rv456/BowlsEye/Code/Pi_BowlsEyeMain/README.md

# Pi_BowlsEyeMain

Main program for raspberry pi

    make
    ./main
