rv456/BowlsEye/Code/SPI/README.md

Simple SPI test using [wiringPi](http://wiringpi.com/) library for reading values from external ADC.

Usage:

    make
    ./spi
