rv456/BowlsEye/Code/StepperMotor/README.md

Example of controlling the stepper motor.  Build and run with:
    
    make
    ./stepper
