rv456/BowlsEye/Code/Thread/README.md

Threading demo using pthreads

Usage:

    make
    ./main
