rv456/BowlsEye/Resources/Presentations/13febpresentation.odp

## Team 18: BowlsEye

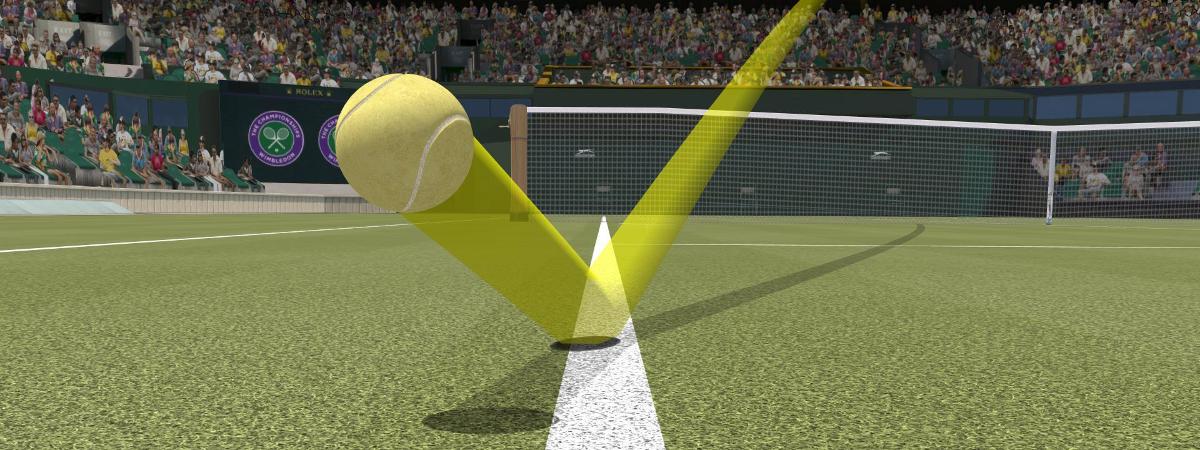
[picture p3: figure]
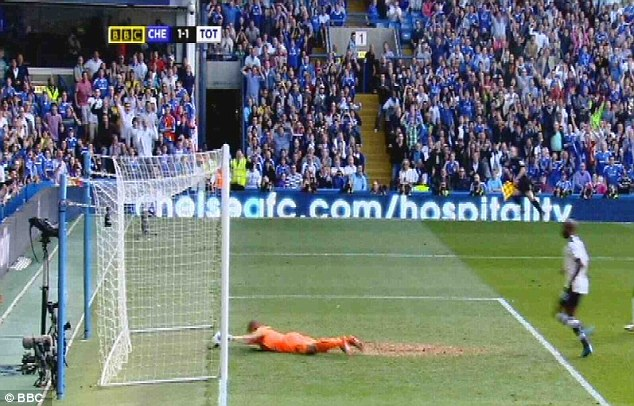
[picture p4: figure]
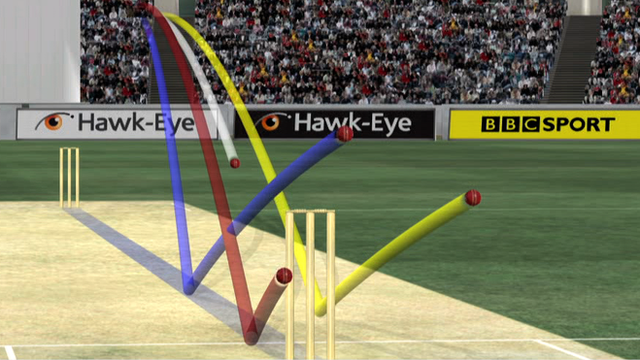
[picture p5: figure]
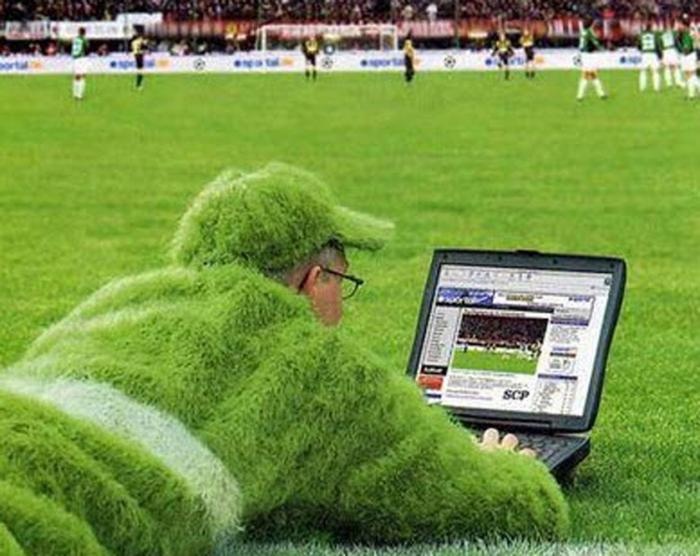
[picture p6: figure]

## Lawn Bowls

- Olympic sport first played in the 13th century
- Player with ball rolled closest to jack wins
- Traditionally measured with tape measure: unreliable!
- Use Raspberry Pi to implement electronic distance sensor

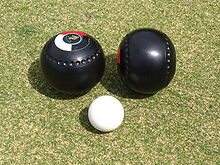
[picture p7: figure]
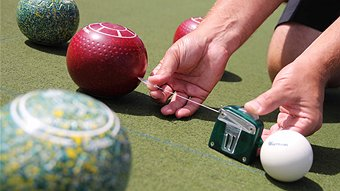
[picture p8: figure]

## System Diagram

## Questions?

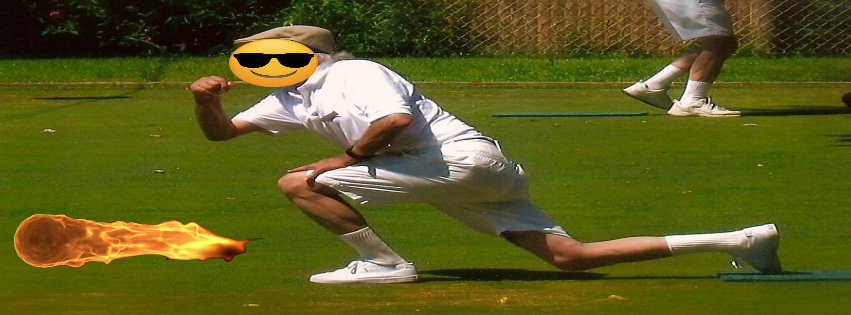
[picture p9: figure]
