rv456/BowlsEye/CAD/base.png

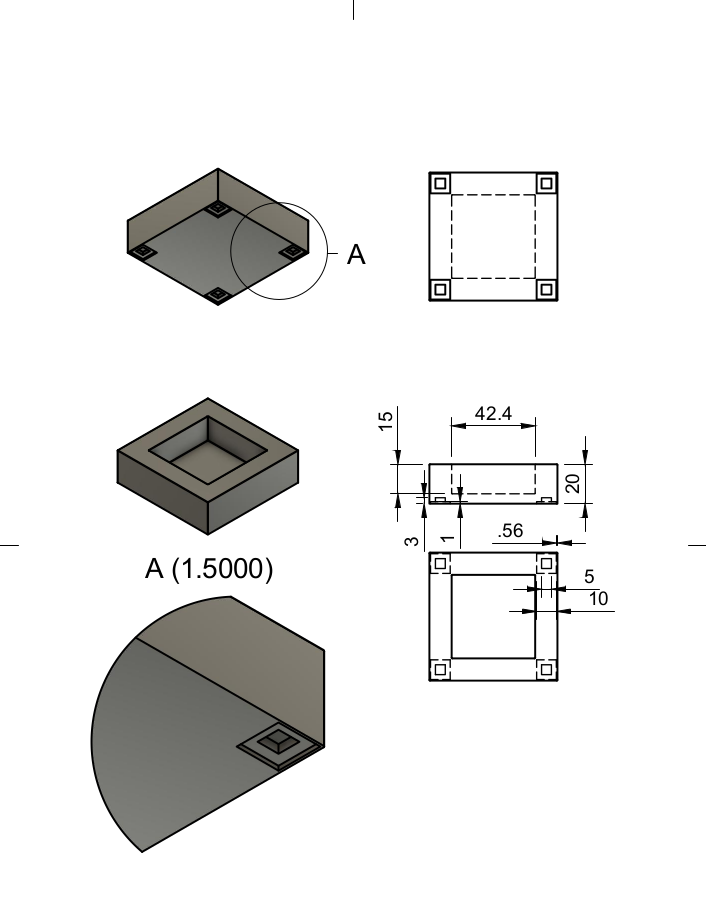
CAD/base.png
