rv456/BowlsEye/CAD/leg.png

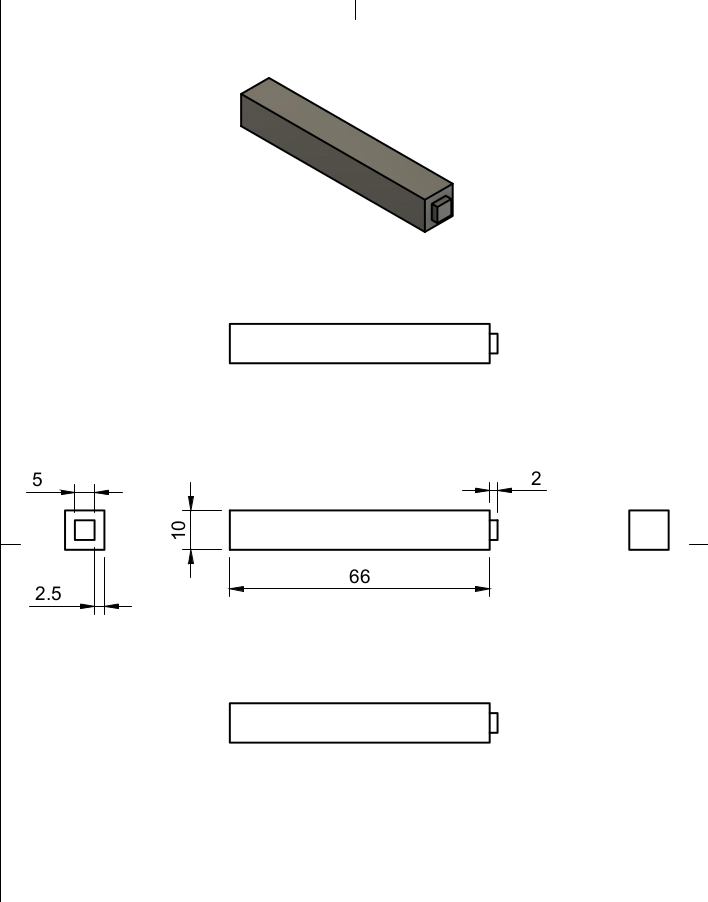
CAD/leg.png
