rv456/BowlsEye/Resources/Misc/gui_screenshot.png

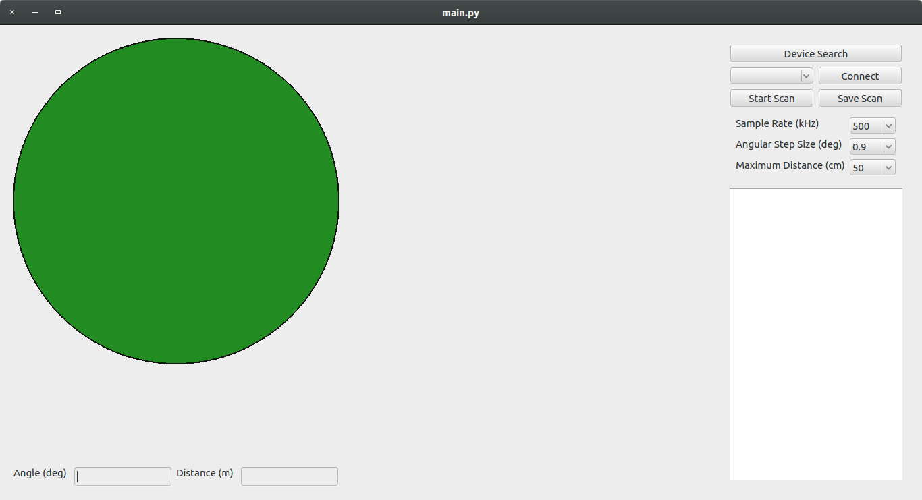
Resources/Misc/gui_screenshot.png
