rv456/BowlsEye/Resources/Misc/Proto1Brd.png

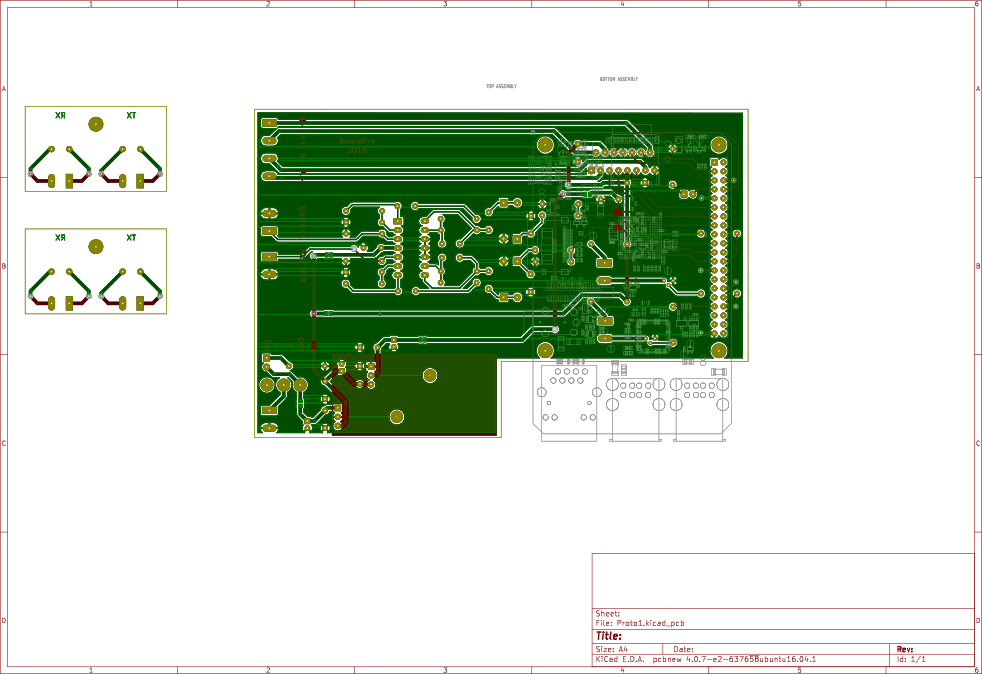
Resources/Misc/Proto1Brd.png
