rv456/BowlsEye/Resources/Misc/Proto2Brd.png

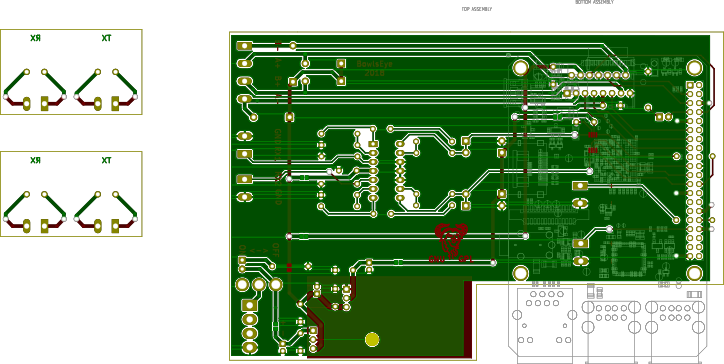
Resources/Misc/Proto2Brd.png
