rv456/BowlsEye/Resources/Misc/softwareDiagram.png

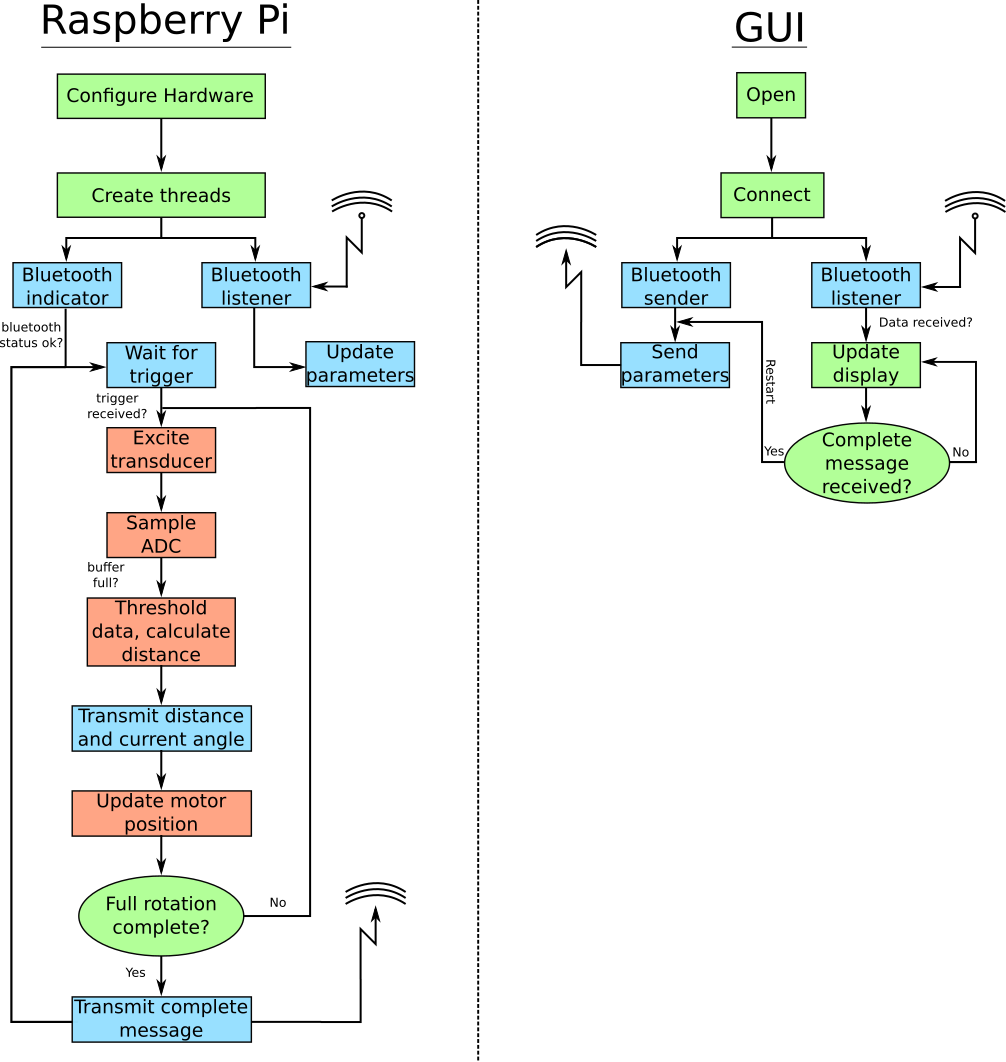
Resources/Misc/softwareDiagram.png
