rv456/BowlsEye/Resources/RPi/Raspberry-Pi-B-Plus-V1.2-Mechanical.dxf

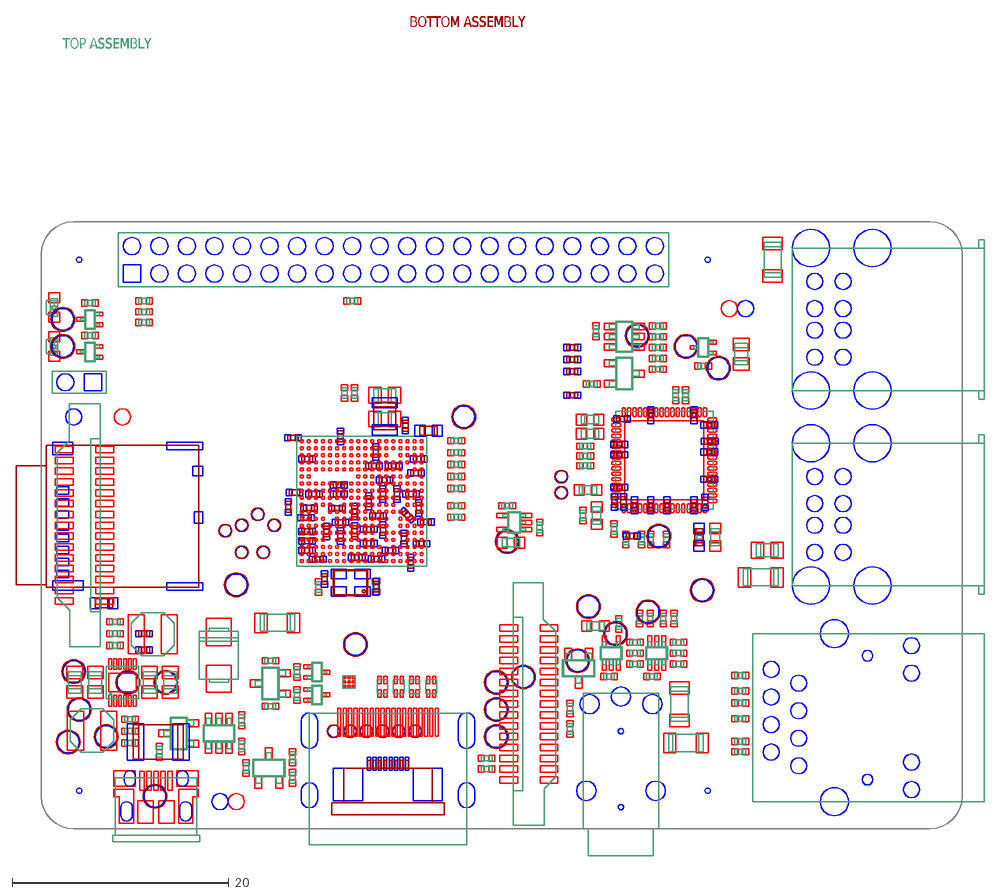
[picture p16: CAD file, 2018-03-19]
Resources/RPi/Raspberry-Pi-B-Plus-V1.2-Mechanical.dxf
BOTTOM ASSEMBLY
TOP ASSEMBLY
