rv456/BowlsEye/(list of files, cad)

Other CAD files:
CAD/box_model_v1.f3d
