rv456/BowlsEye/CAD/assembly.png

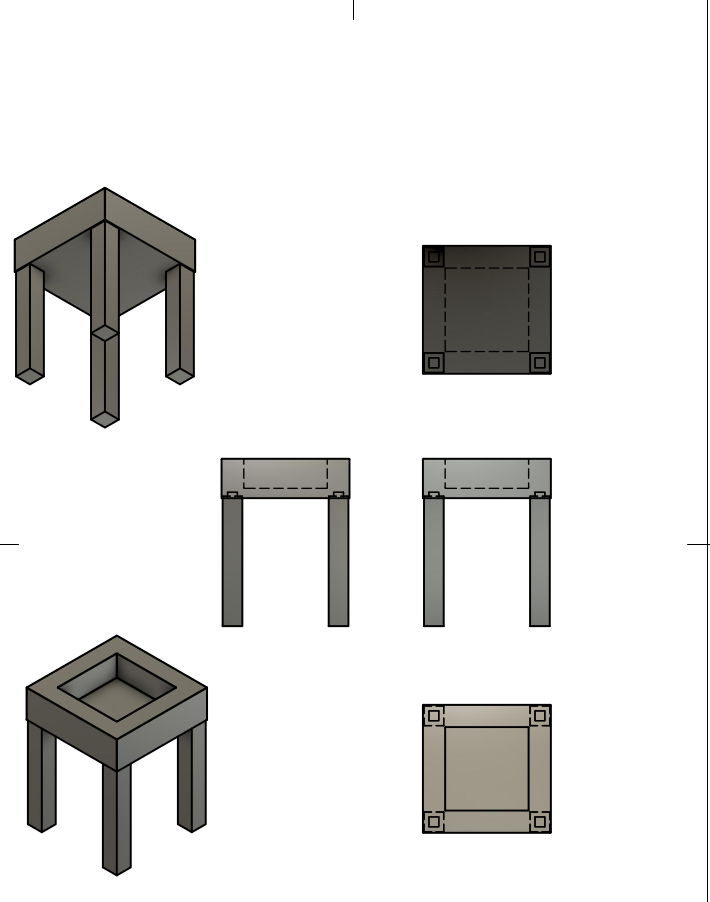
CAD/assembly.png
