rv456/BowlsEye/Results/F0001TEK.JPG

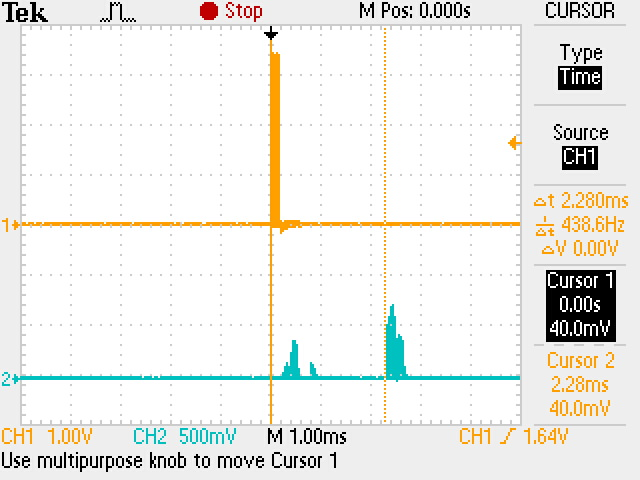
Results/F0001TEK.JPG
