rv456/BowlsEye/Results/F0002TEK.JPG

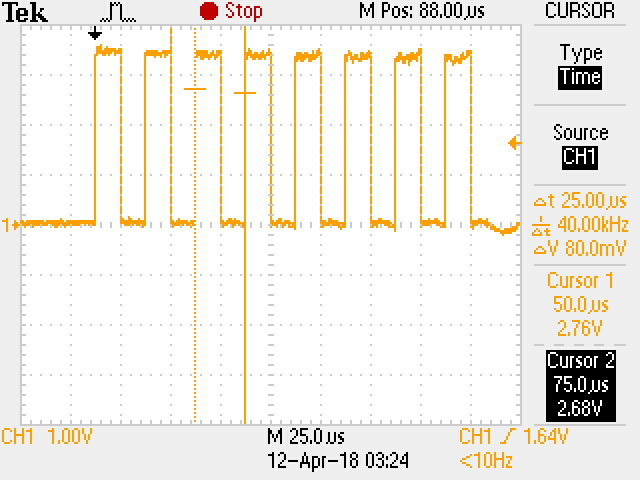
Results/F0002TEK.JPG
