rv456/BowlsEye/Planner/todo.odt

To Do List

Urgent: FOR NEXT WEEK (14/2/18):

ADC interface:(H+C)

Spi w/ any signal

Stepper motor stepping research:(H)

drive signal

hardware required

Ultrasound w/ scope & sig gen:(C)

signal level in/out

distance(?)

rectify(?)

Breadboarding:

ultrasound(C)

motor driving(H)

Presentation:(H+C)

Slides: system block diagram

Readme: description → plan

answer list of questions

Gantt chart(?)

pictures of individuals playing bowls

Moderate:

Software architecture:

no. of threads

data in/out

BLOCK DIAGRAM

Bluetooth:

http://people.csail.mit.edu/albert/bluez-intro/c404.html

laptop → pi

pi → laptop

Hardware design:

Ultrasound driving/reading PCB

Stepper motor driving

PIN map

GUI (python):

draw circles (green background, white middle, black bowls)

Chill:

Ultrasound from pi

Increasing speed
