rv456/BowlsEye/(threads)

Thread 2 (2018-03-14):

Software Information

croaljack0, 2018-03-14:
Further information on how the software is constructed would be helpful.
This could be a description of the classes, or a UML diagram etc.

** Team 10 **

rv456, 2018-03-15:
Thank you for highlighting this issue, our final code will be fully documented!

rv456, 2018-03-25:
We have added documentation for the current raspberry pi codebase [here](https://rv456.github.io/BowlsEye/index.html).  We will continue to update this resource as we finalise the software for both the raspberry pi and the GUI.

Thanks,
- Team 18

Closed 2018-03-25.

Thread 3 (2018-03-14):

Need more information about the work flow of the whole project.

JiananKan, 2018-03-14:
To provide some UML graphs maybe a good way to describe.

team 6

rv456, 2018-03-15:
Thank you for highlighting this issue, we are currently working on code documentation

rv456, 2018-03-25:
Hi, we have added the current documented code [here](https://rv456.github.io/BowlsEye/index.html) where you can see include dependency and call graphs.  We will continue to maintain this and have also updated the main README to give an overview of the structure of the full repository.

Thanks
- Team 18

Closed 2018-03-25.
