rv456/BowlsEye/KiCad/Shield/Proto2/Fabrication/PDFs/Proto2-B.Cu.pdf

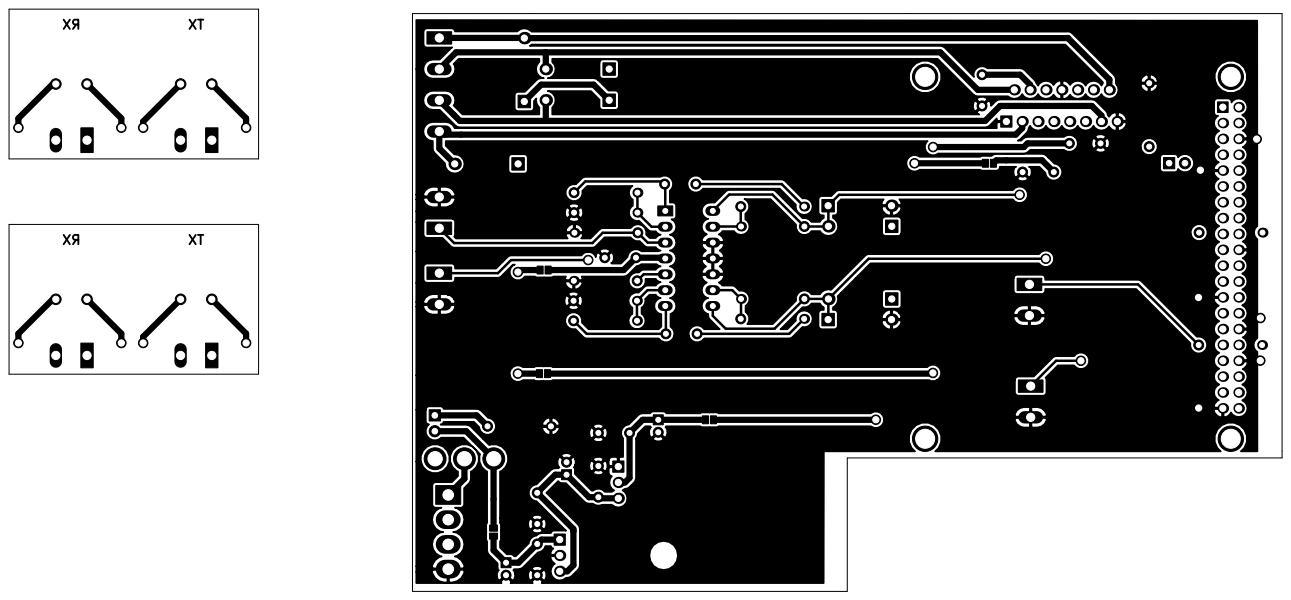
[picture p20: page 1]
