rv456/BowlsEye/KiCad/Shield/Proto2/Fabrication/PDFs/Proto2-brd.pdf

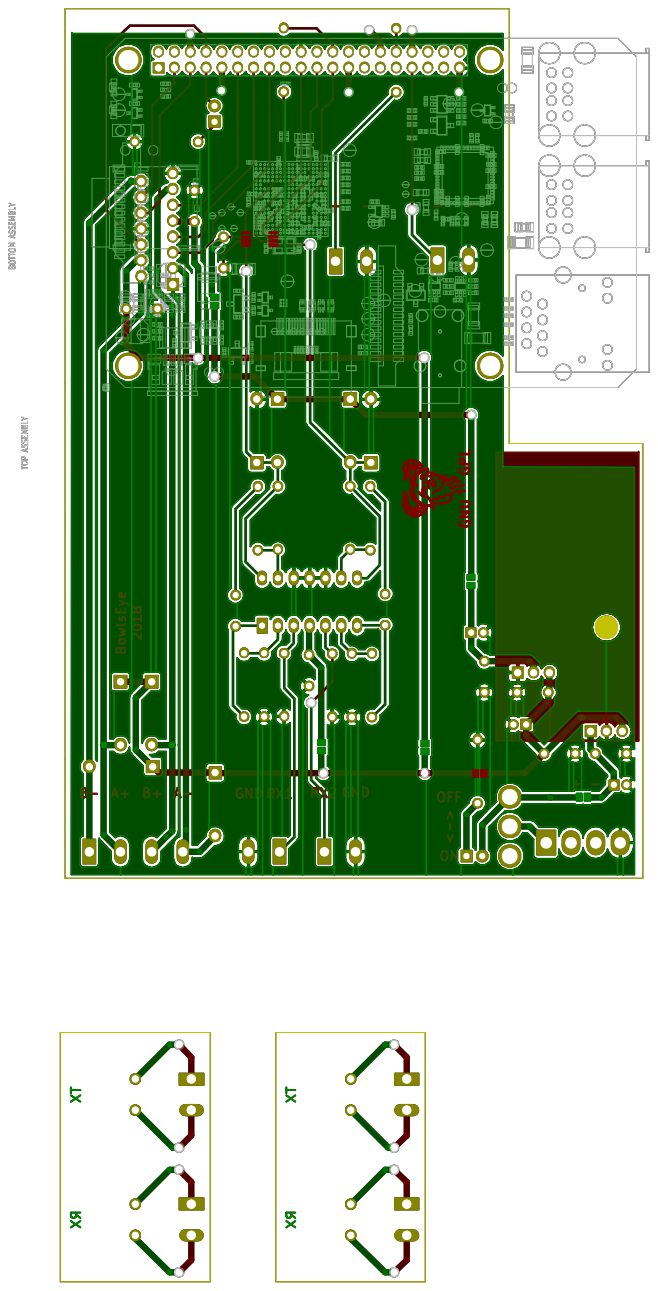
[picture p21: page 1]
