rv456/BowlsEye/KiCad/Shield/Proto2/Fabrication/PDFs/Proto2-F.Cu.pdf

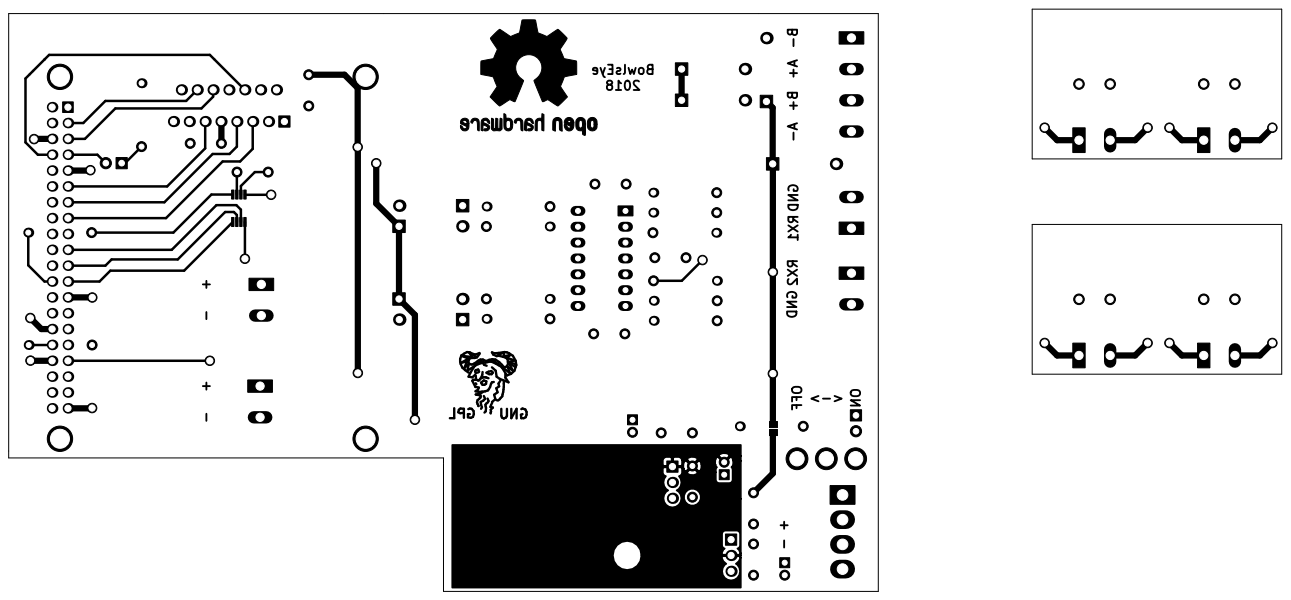
[picture p22: page 1]
