rv456/BowlsEye/KiCad/Shield/Proto1/Fabrication/PDFs/bowlsEyeBoards.pdf

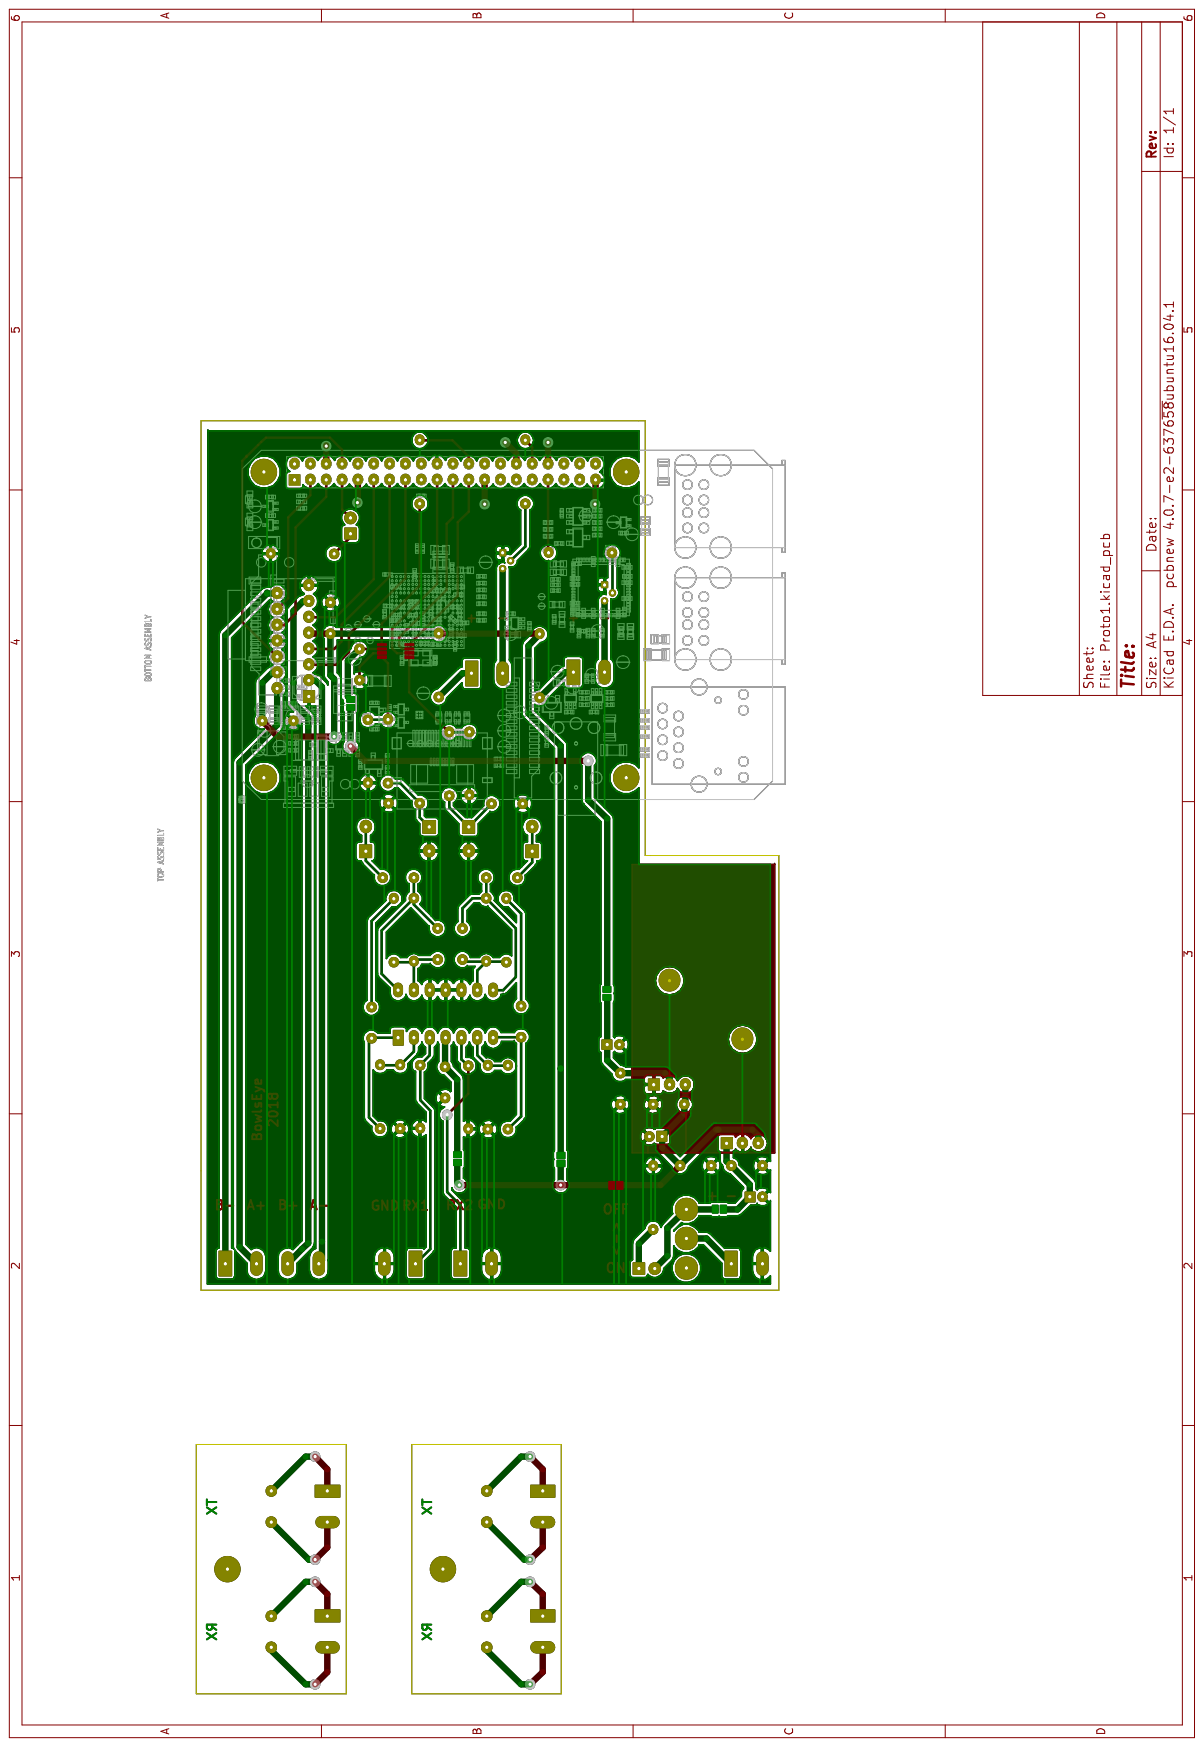
[picture p23: page 1]
