rv456/BowlsEye/KiCad/Shield/Proto1/Fabrication/PDFs/mainBottom.pdf

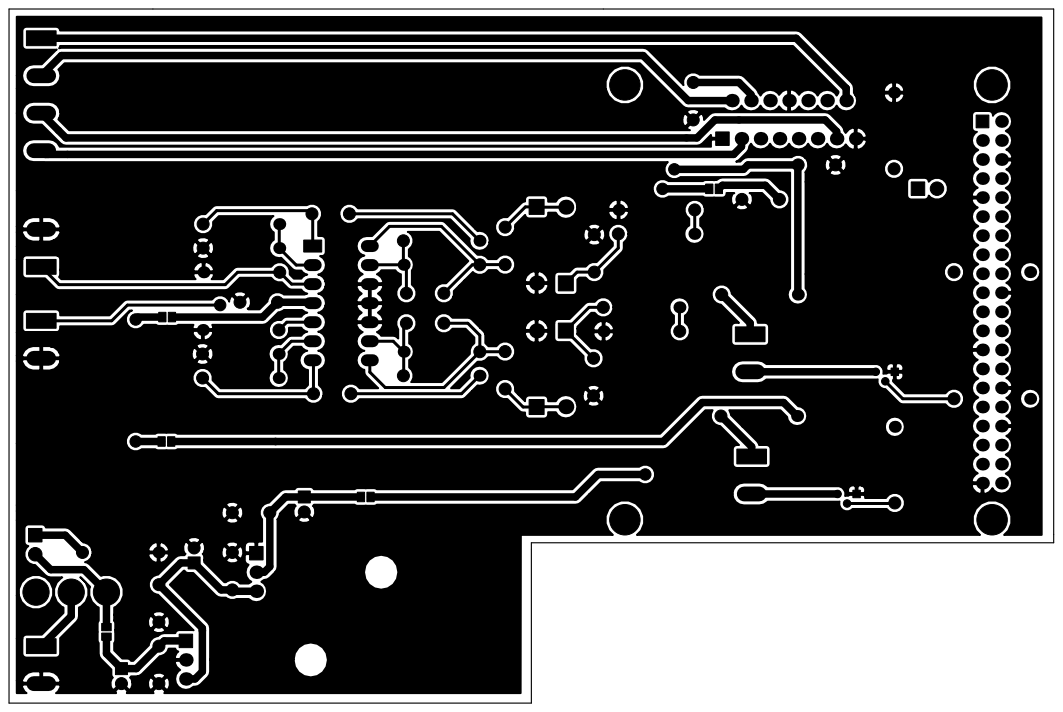
[picture p24: page 1]
