rv456/BowlsEye/KiCad/Shield/Proto1/Fabrication/PDFs/mainTop.pdf

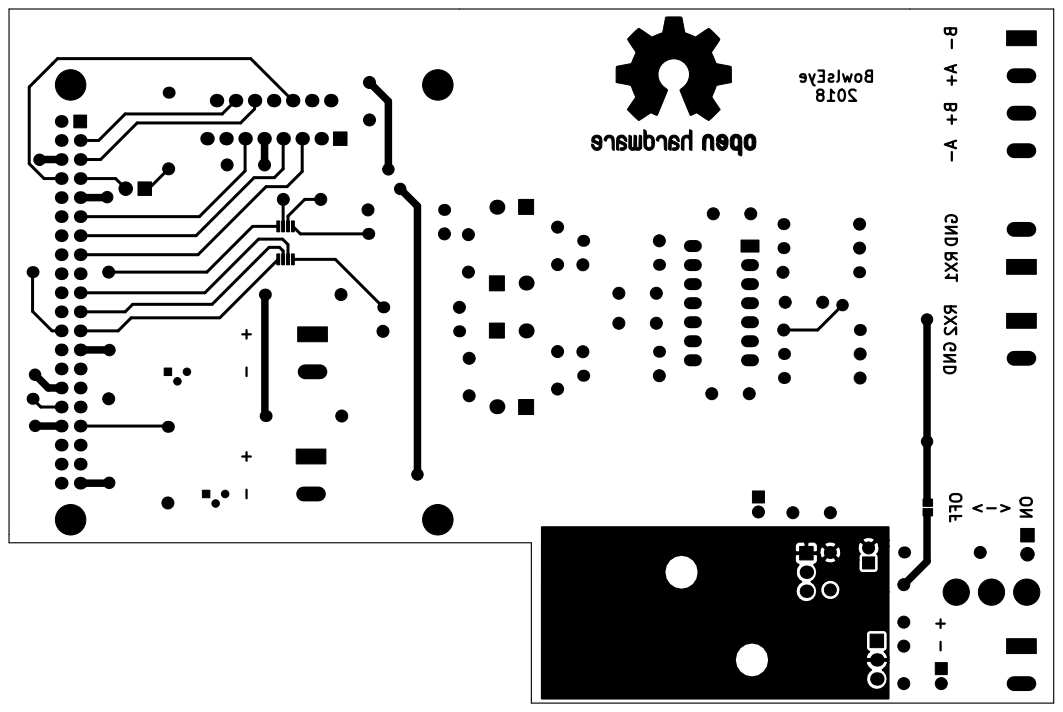
[picture p25: page 1]
