rv456/BowlsEye/KiCad/Shield/Proto1/Fabrication/PDFs/schematics.pdf

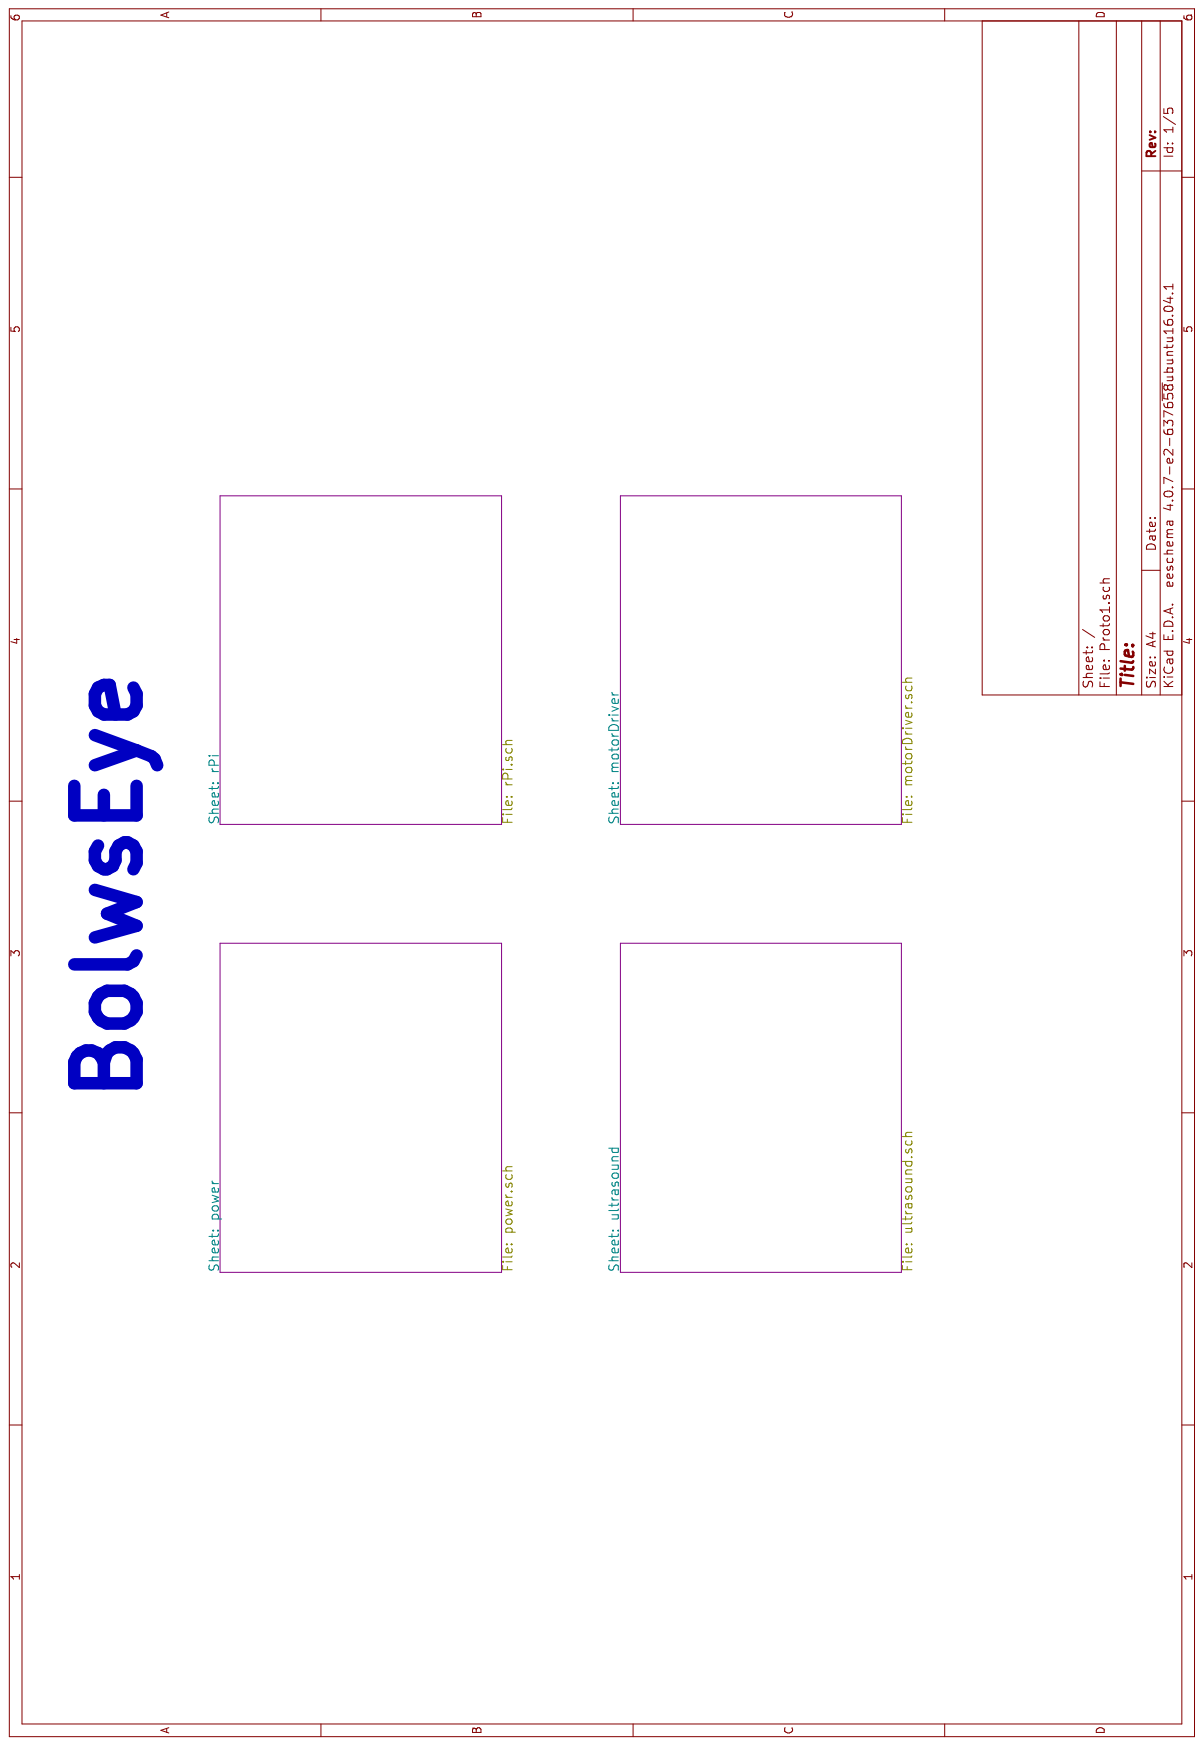
[picture p26: page 1]

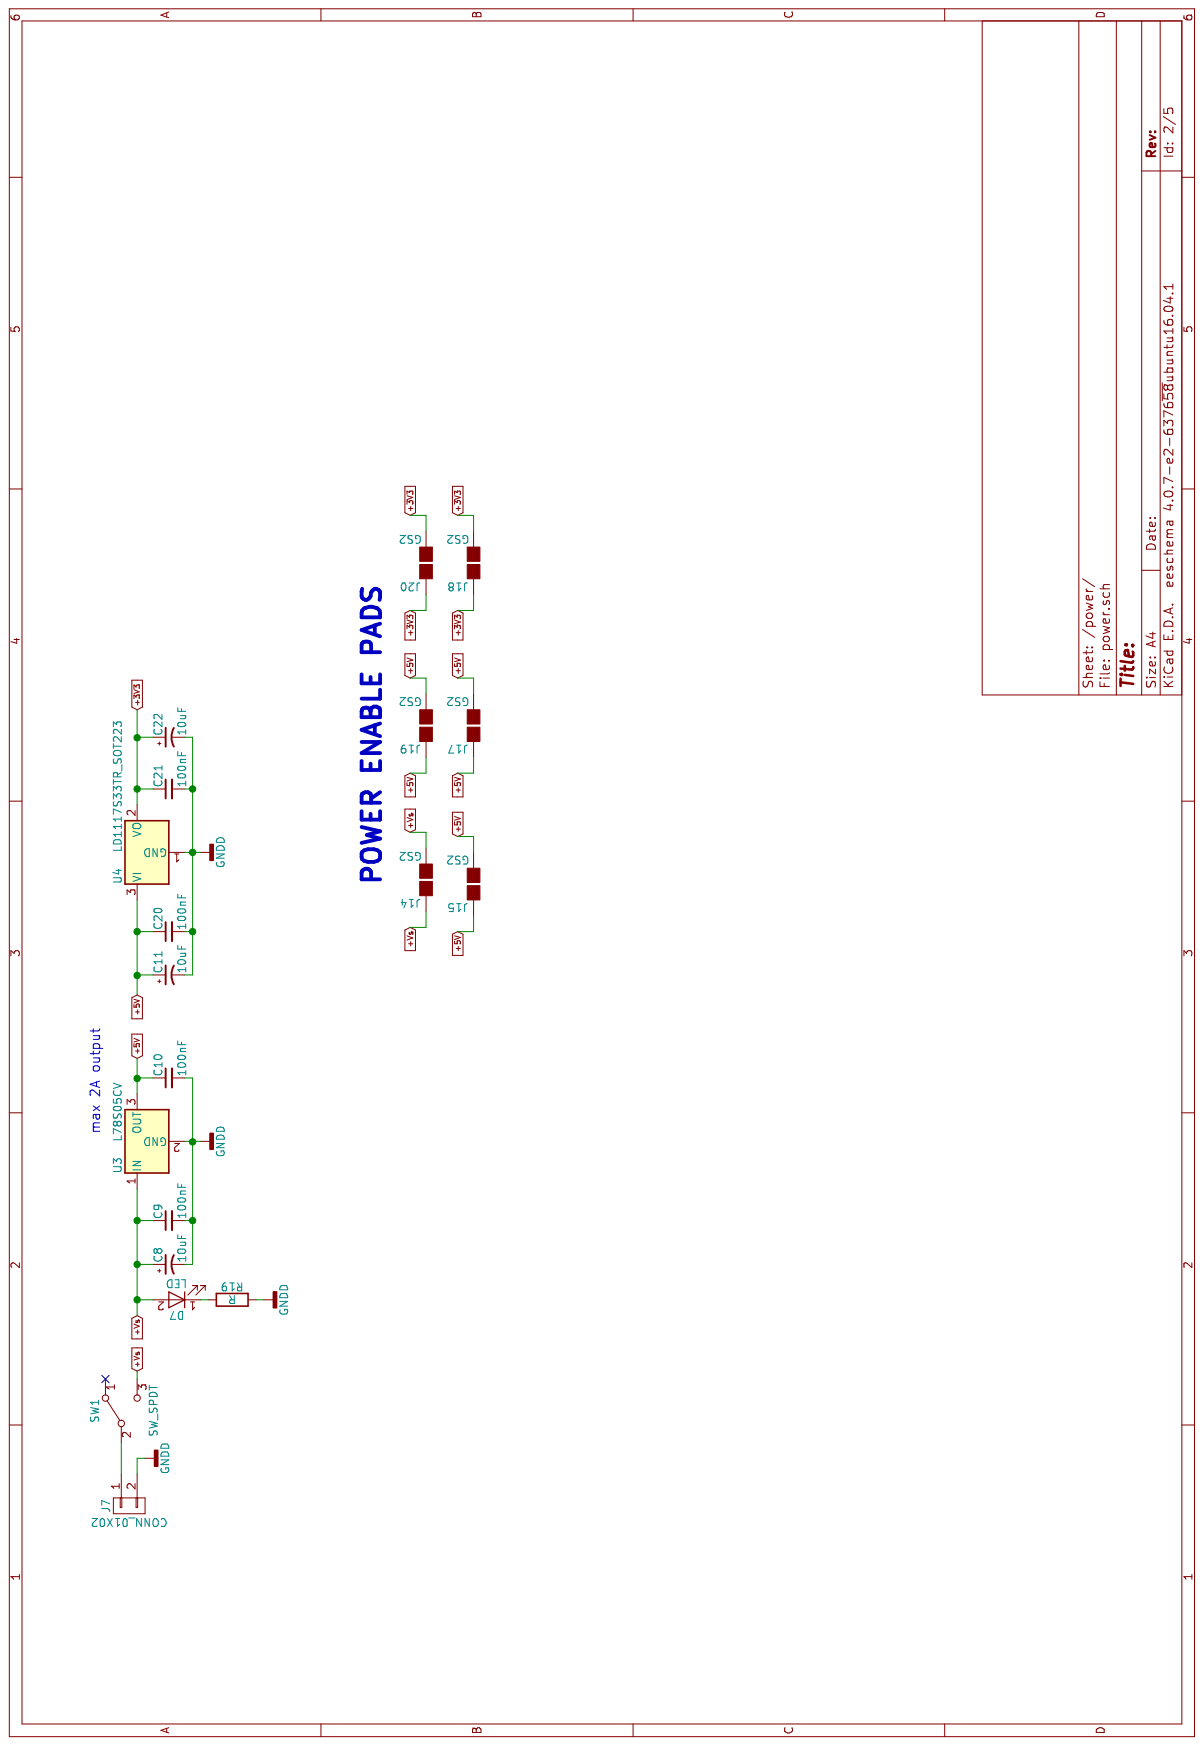
[picture p27: page 2]

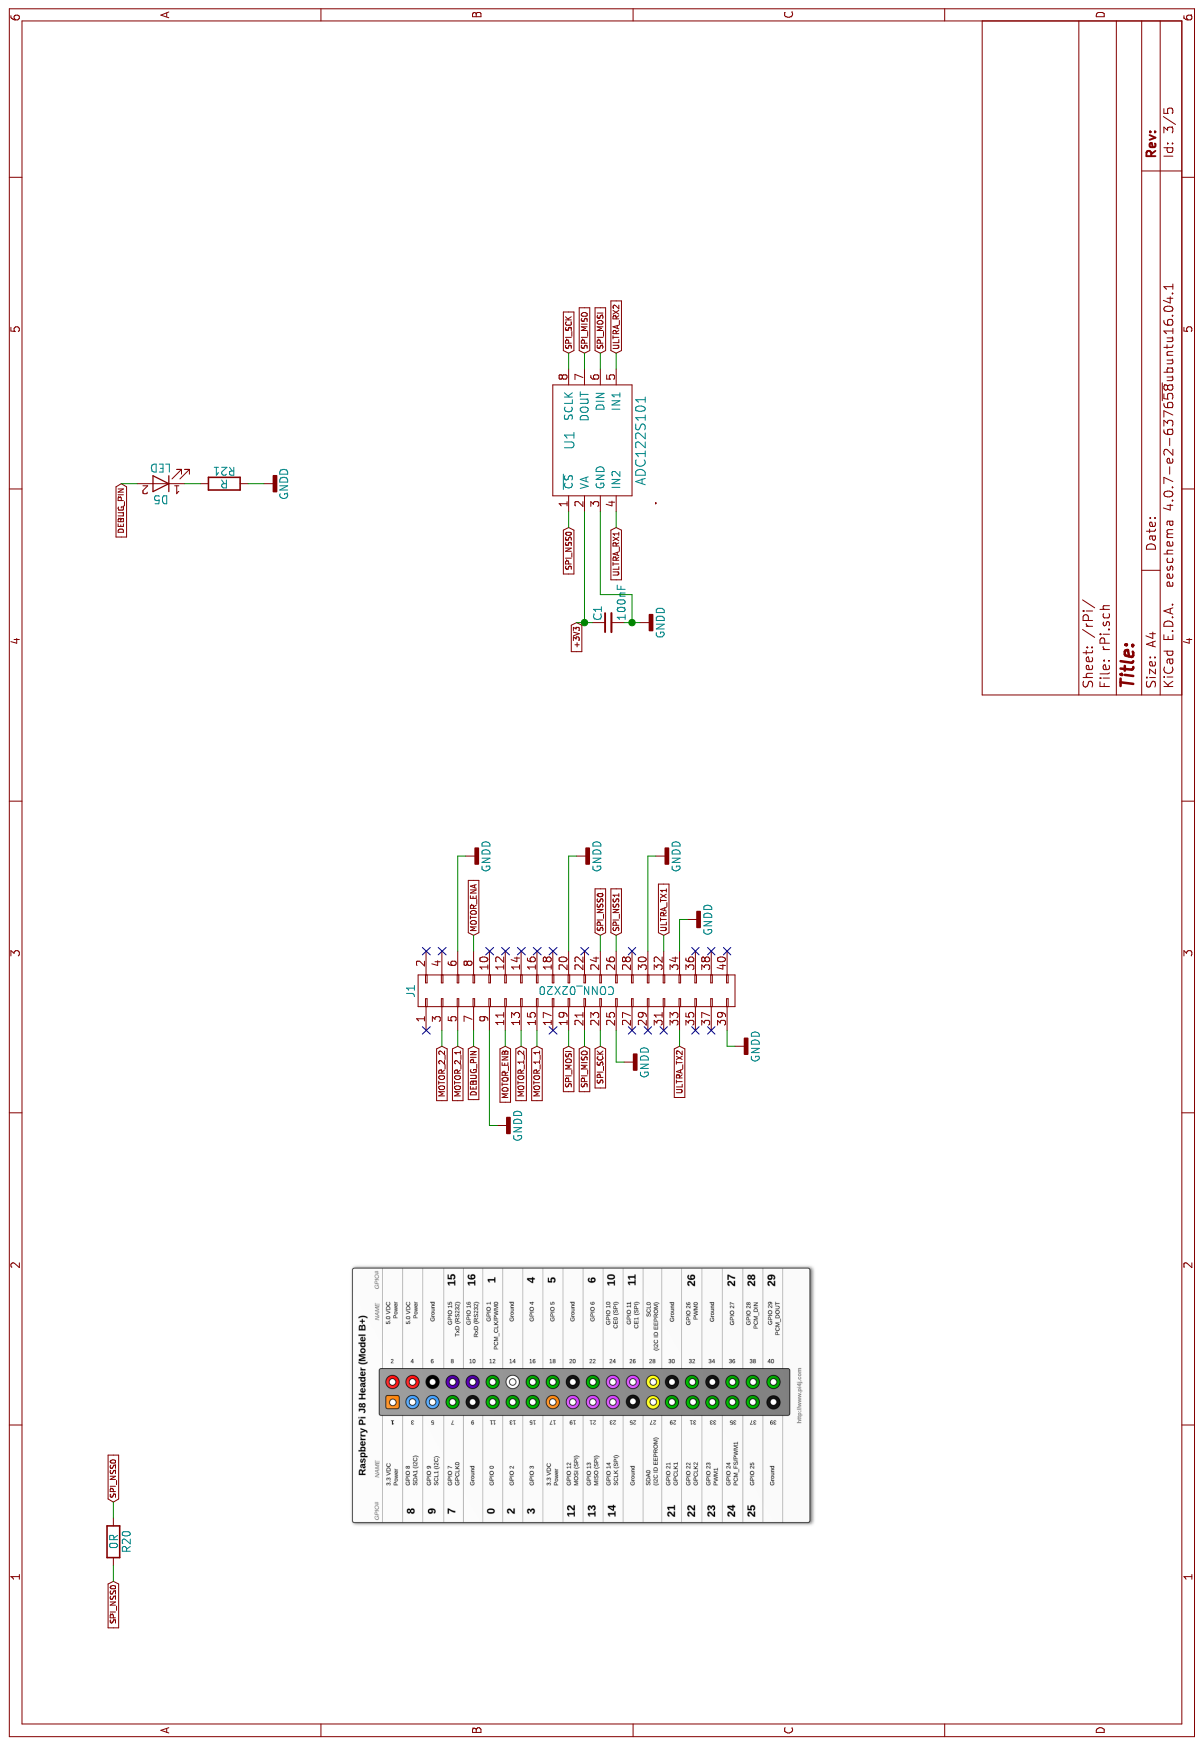
[picture p28: page 3]

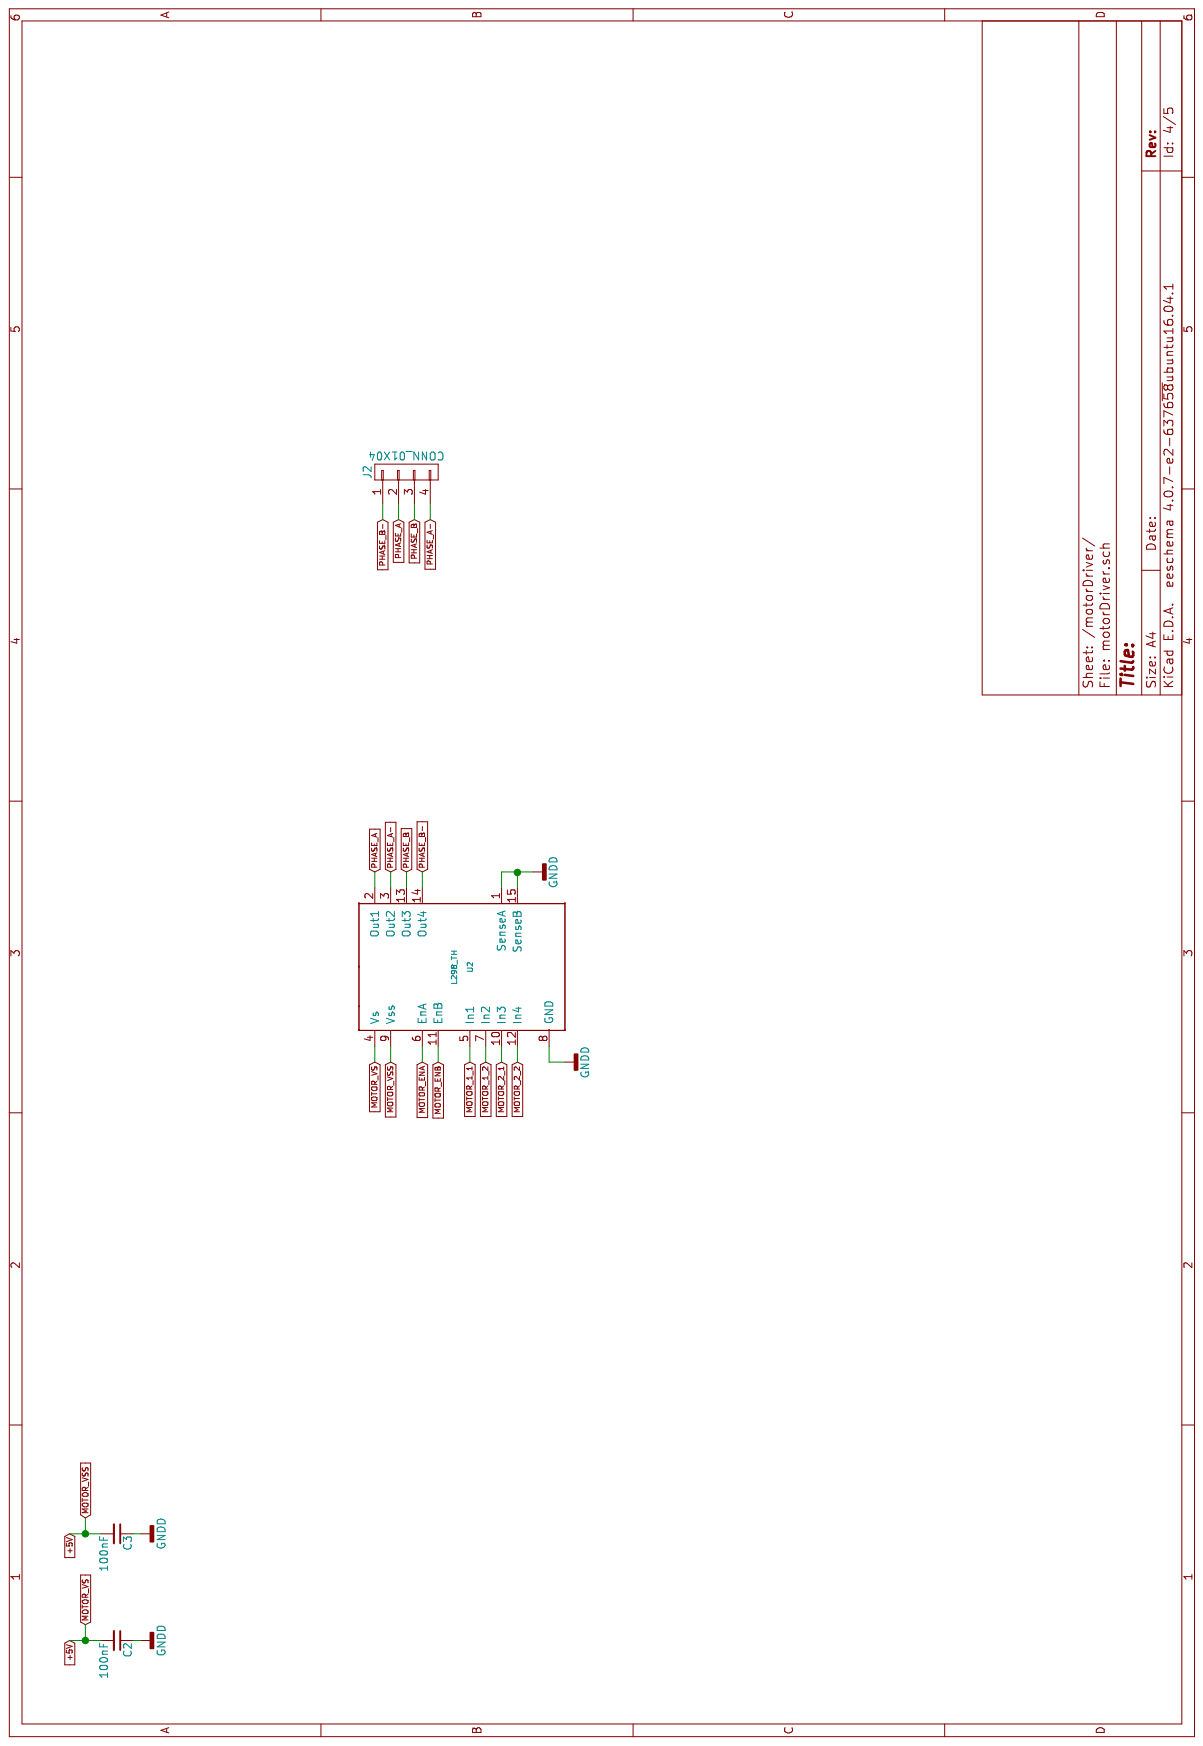
[picture p29: page 4]

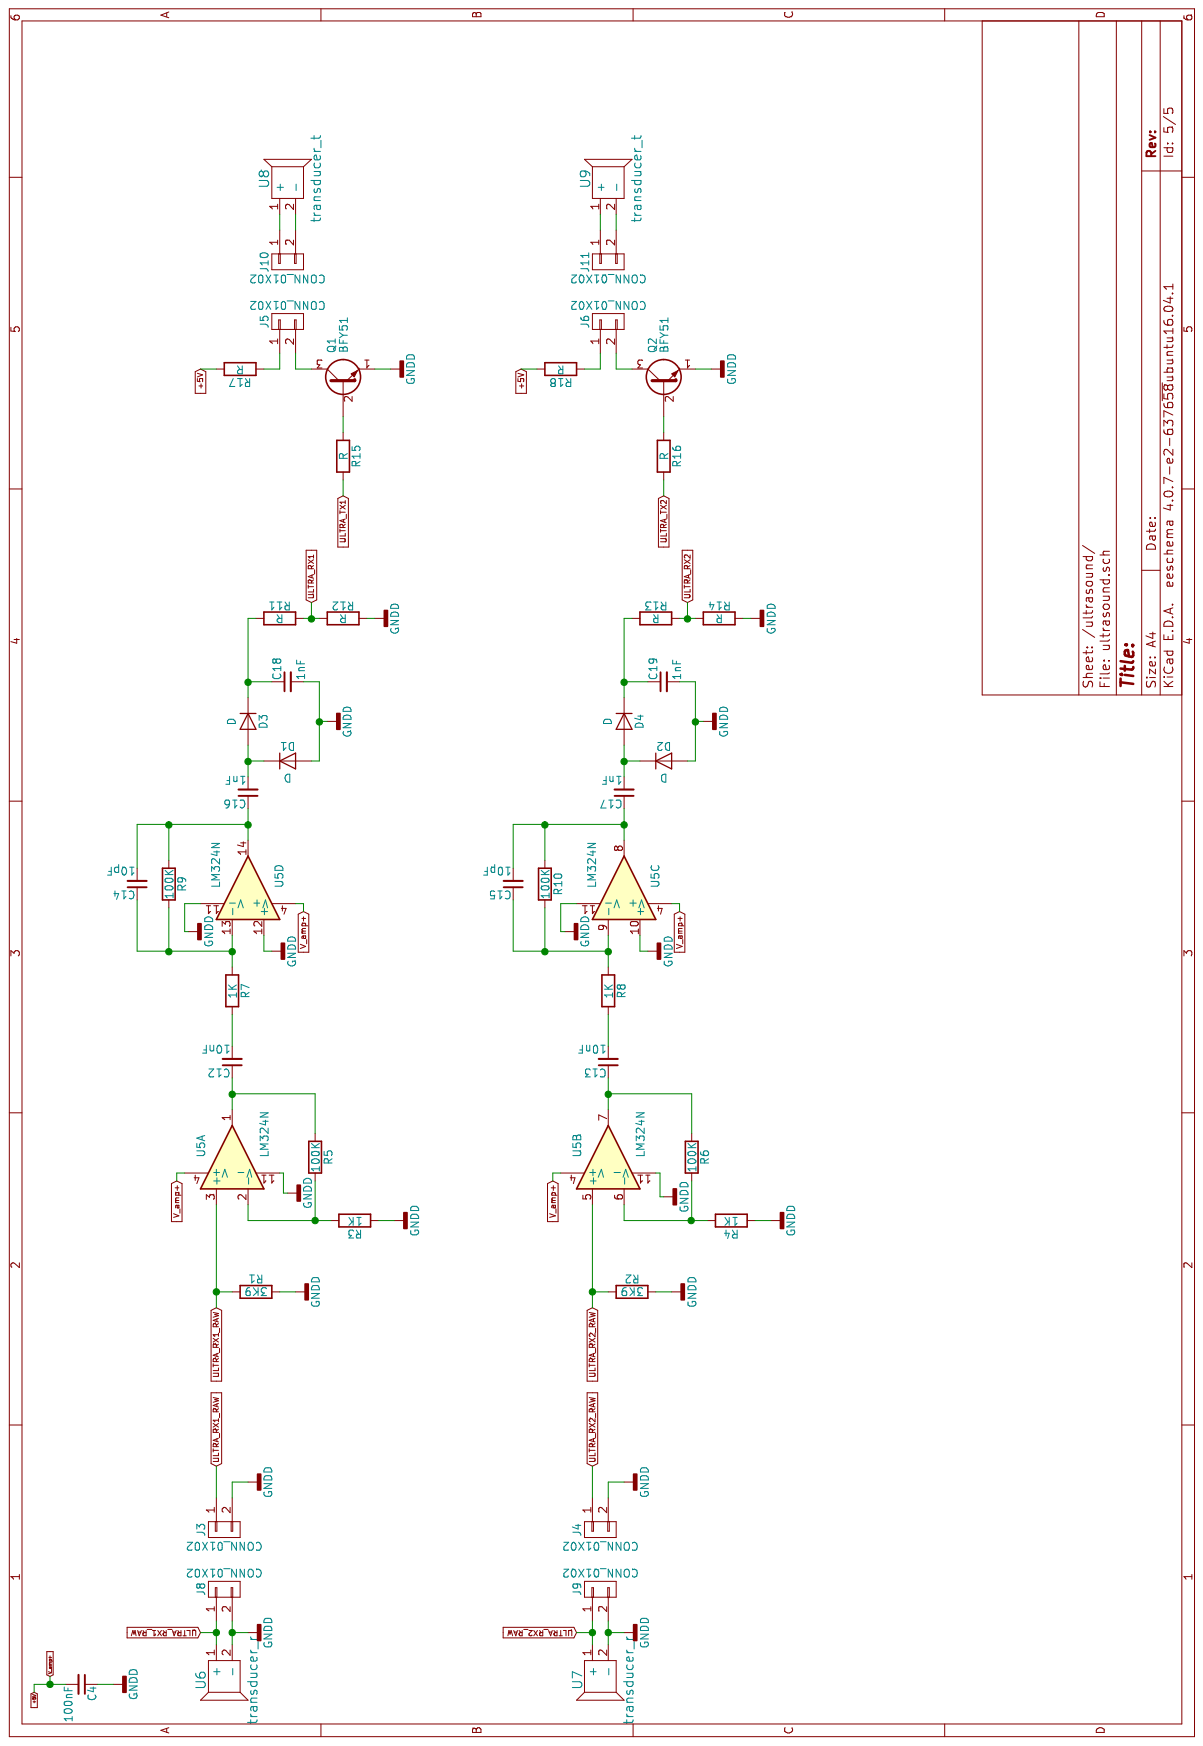
[picture p30: page 5]
