rv456/BowlsEye/KiCad/Shield/Proto1/Fabrication/PDFs/ultraBottom.pdf

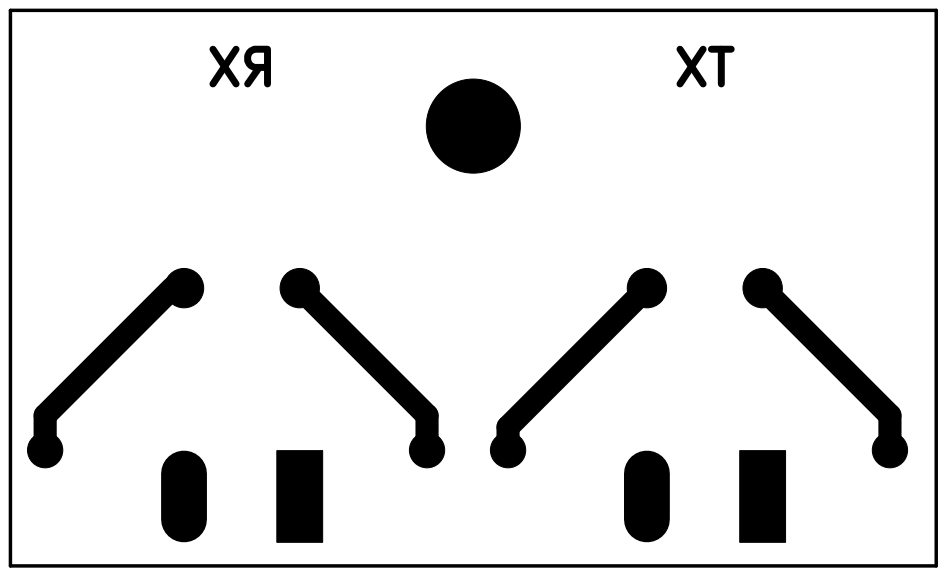
[picture p31: page 1]
