rv456/BowlsEye/KiCad/Shield/Proto1/Fabrication/PDFs/ultraTop.pdf

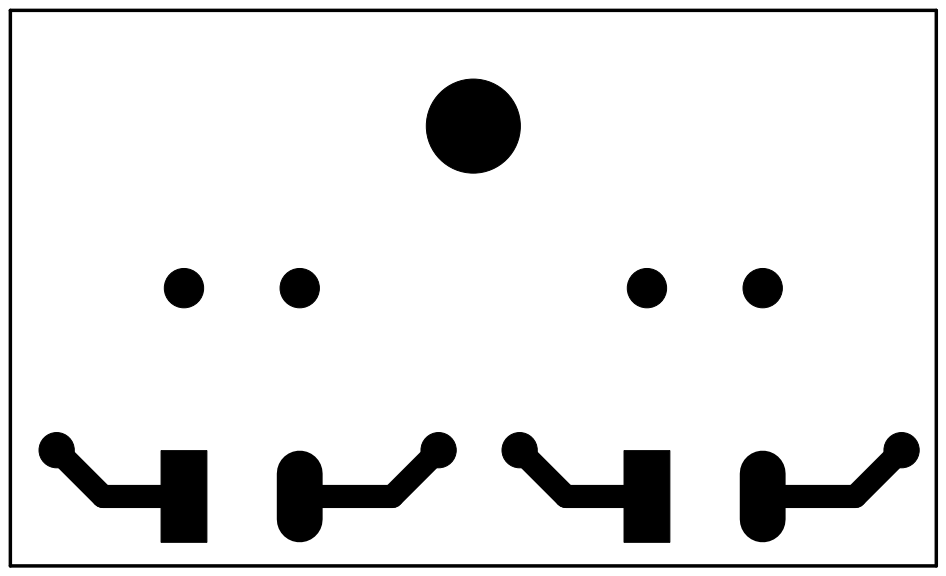
[picture p32: page 1]
