rv456/BowlsEye/KiCad/ADCBreakout/boardwMarker.pdf

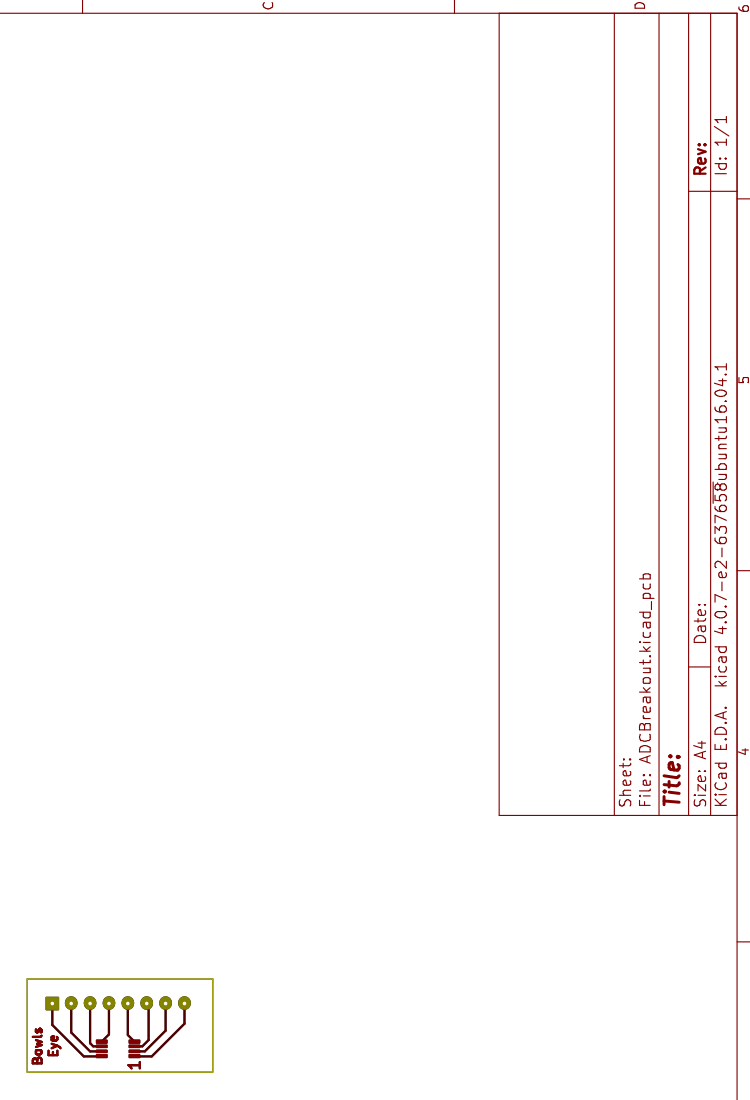
[picture p33: page 1]

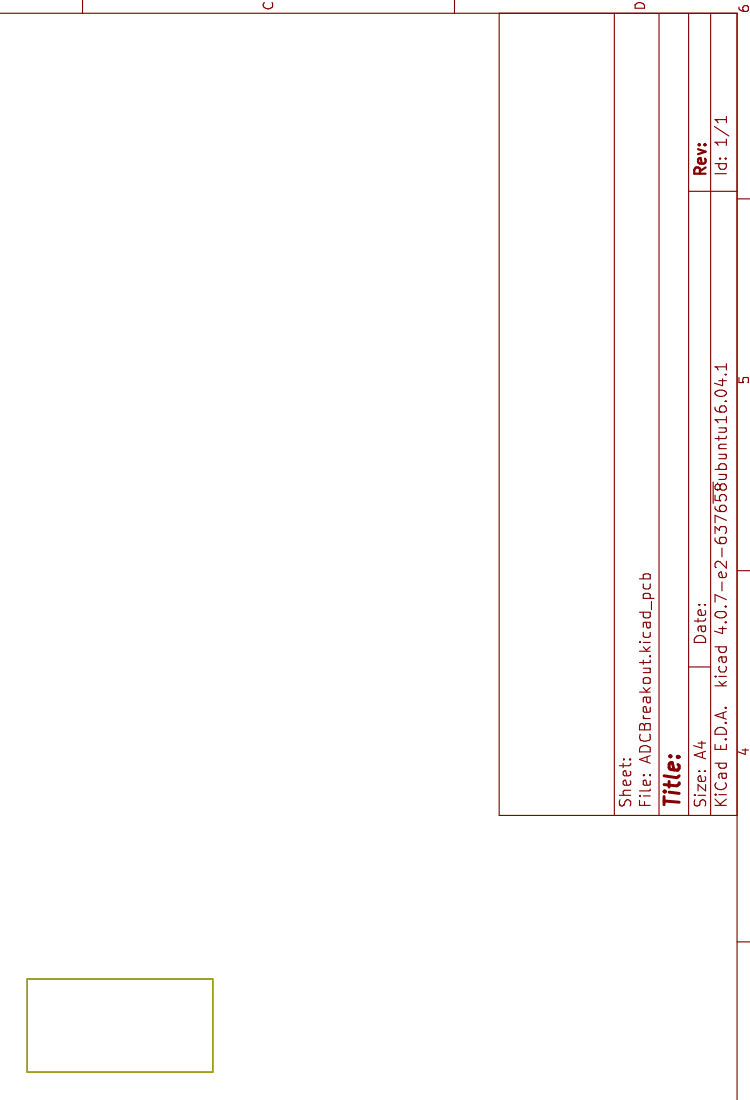
[picture p34: page 2]

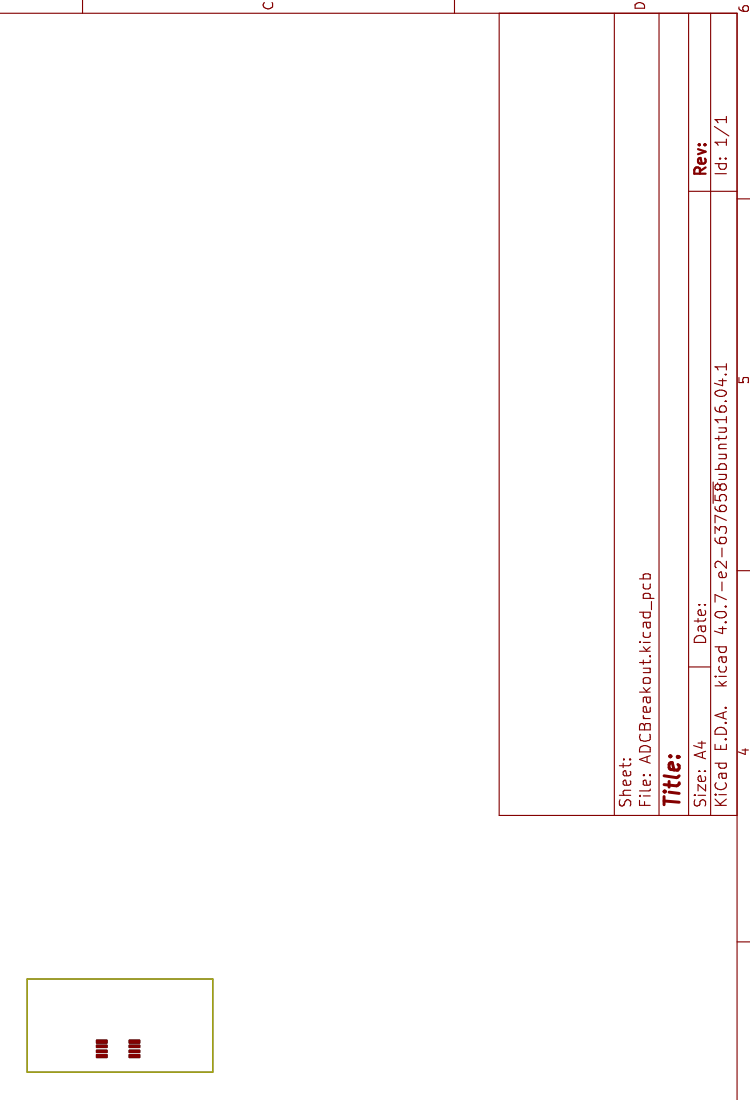
[picture p35: page 3]

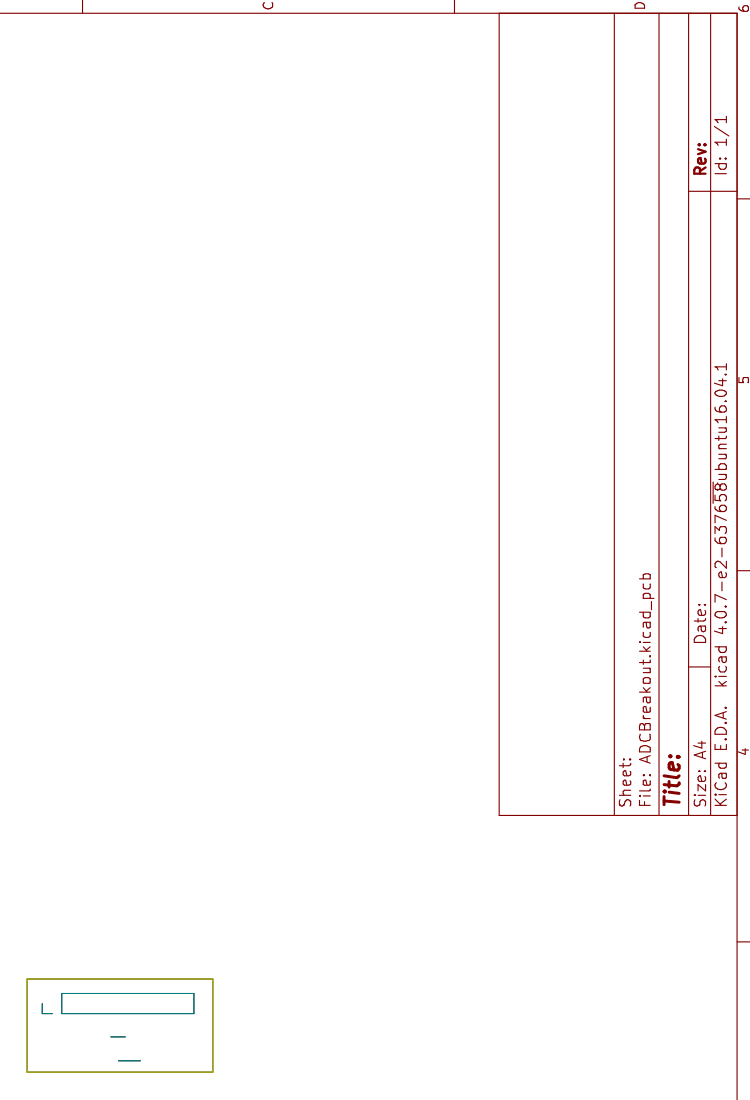
[picture p36: page 4]

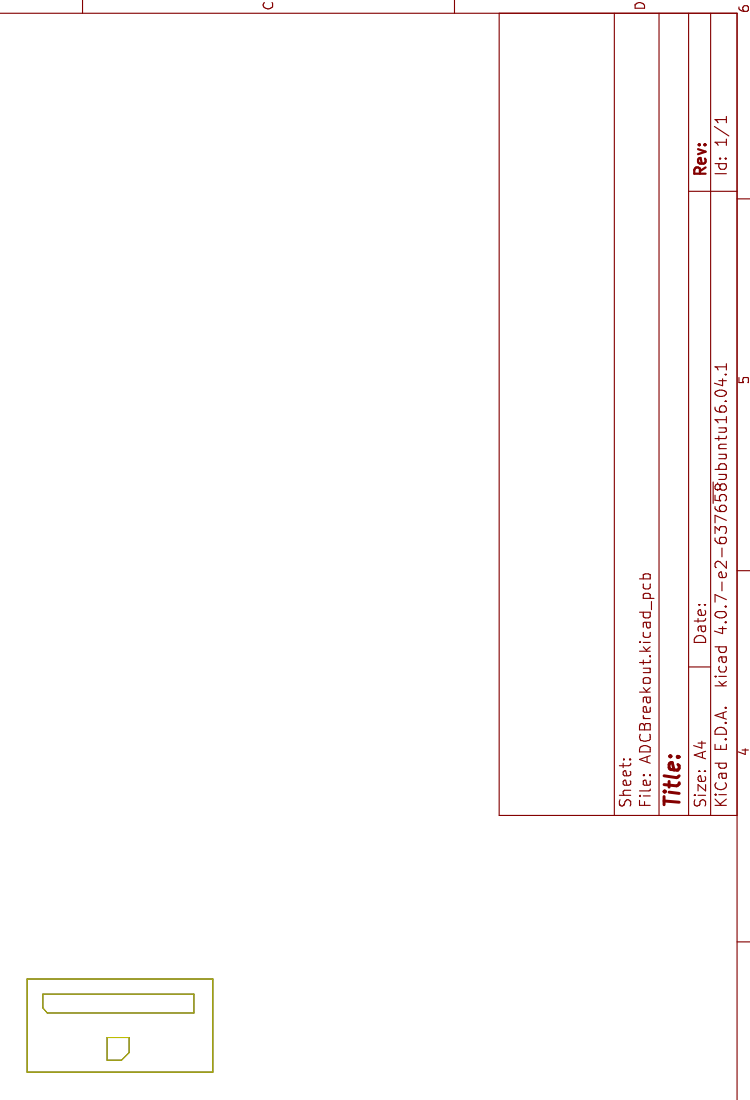
[picture p37: page 6]
