rv456/BowlsEye/KiCad/ADCBreakout/ADCBreakoutTopMirrored.pdf

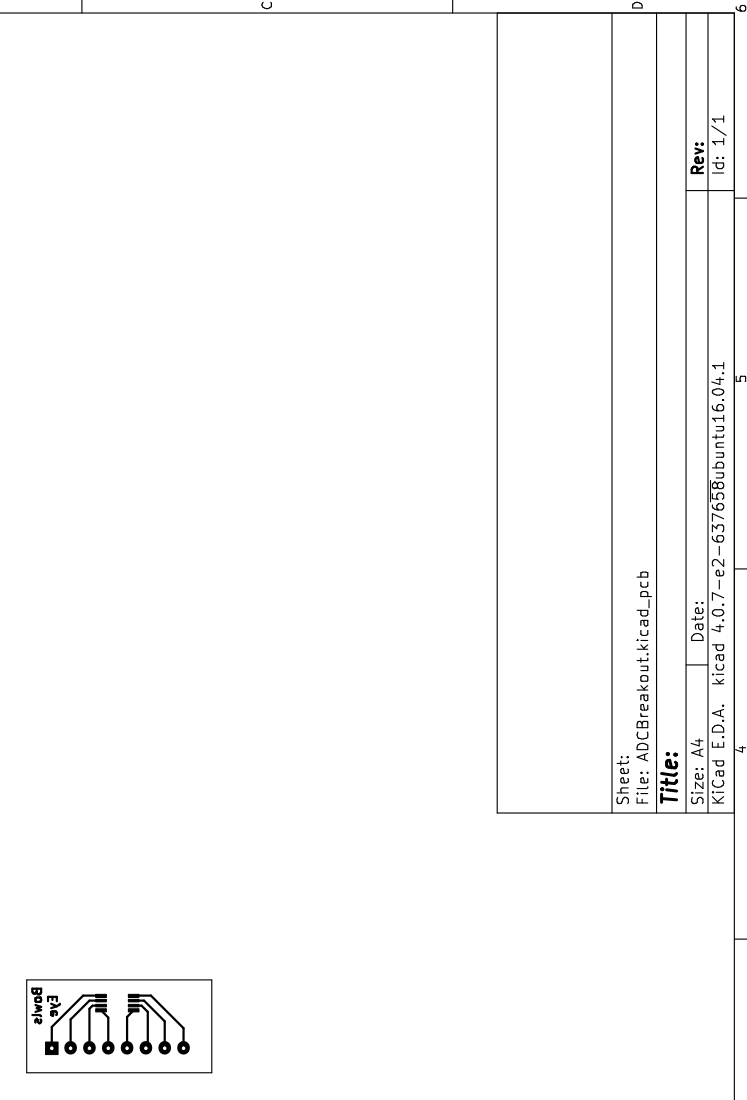
[picture p38: page 1]
