rv456/BowlsEye/KiCad/Shield/Proto2/Proto2.kicad_pcb

## KiCad design KiCad/Shield/Proto2/Proto2.kicad_pcb (2018-04-15)

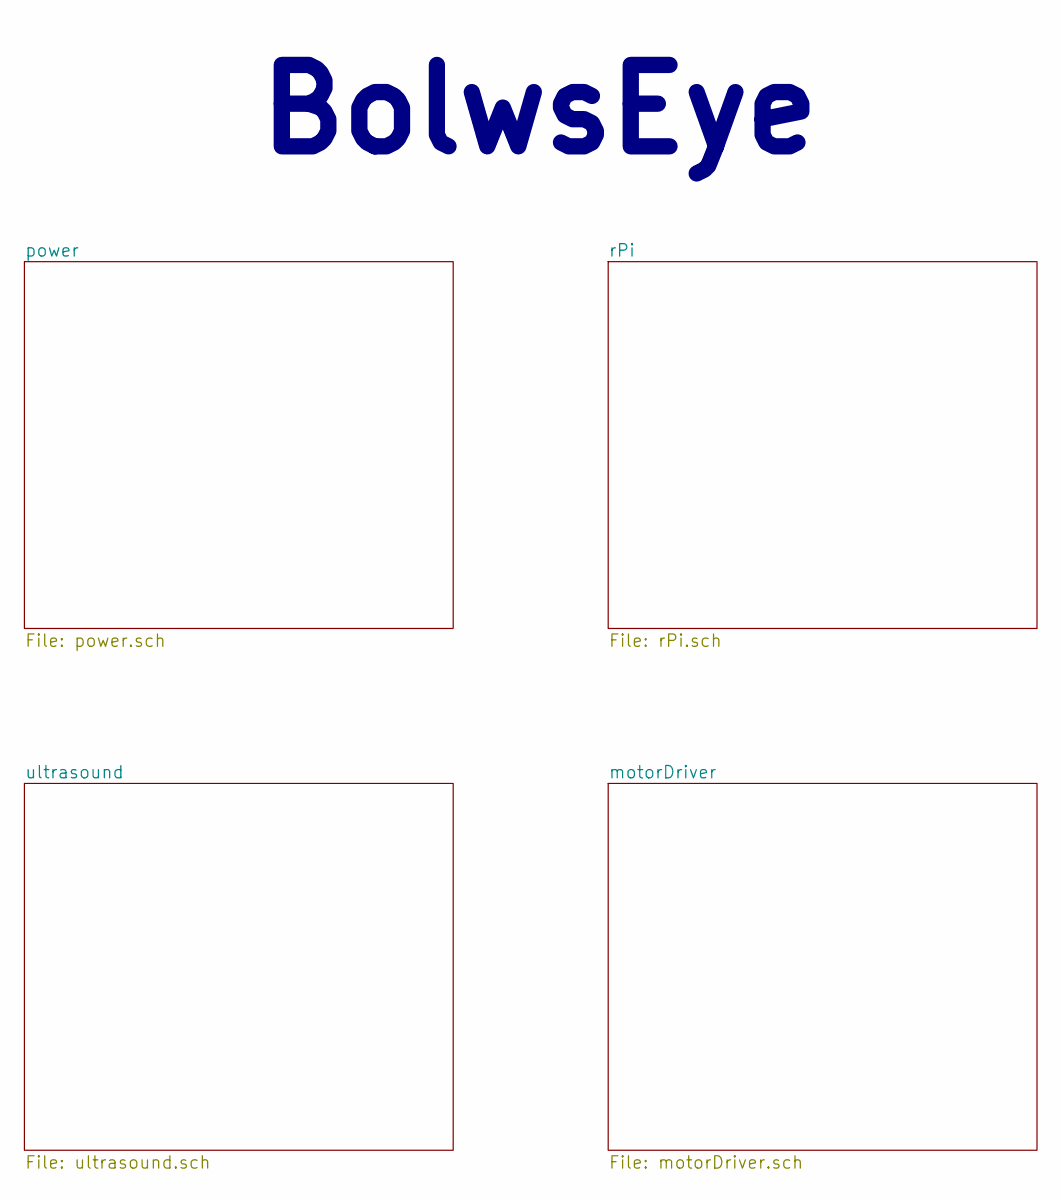
[picture p39: schematic Proto2.sch]

Notes on the sheet:
BolwsEye

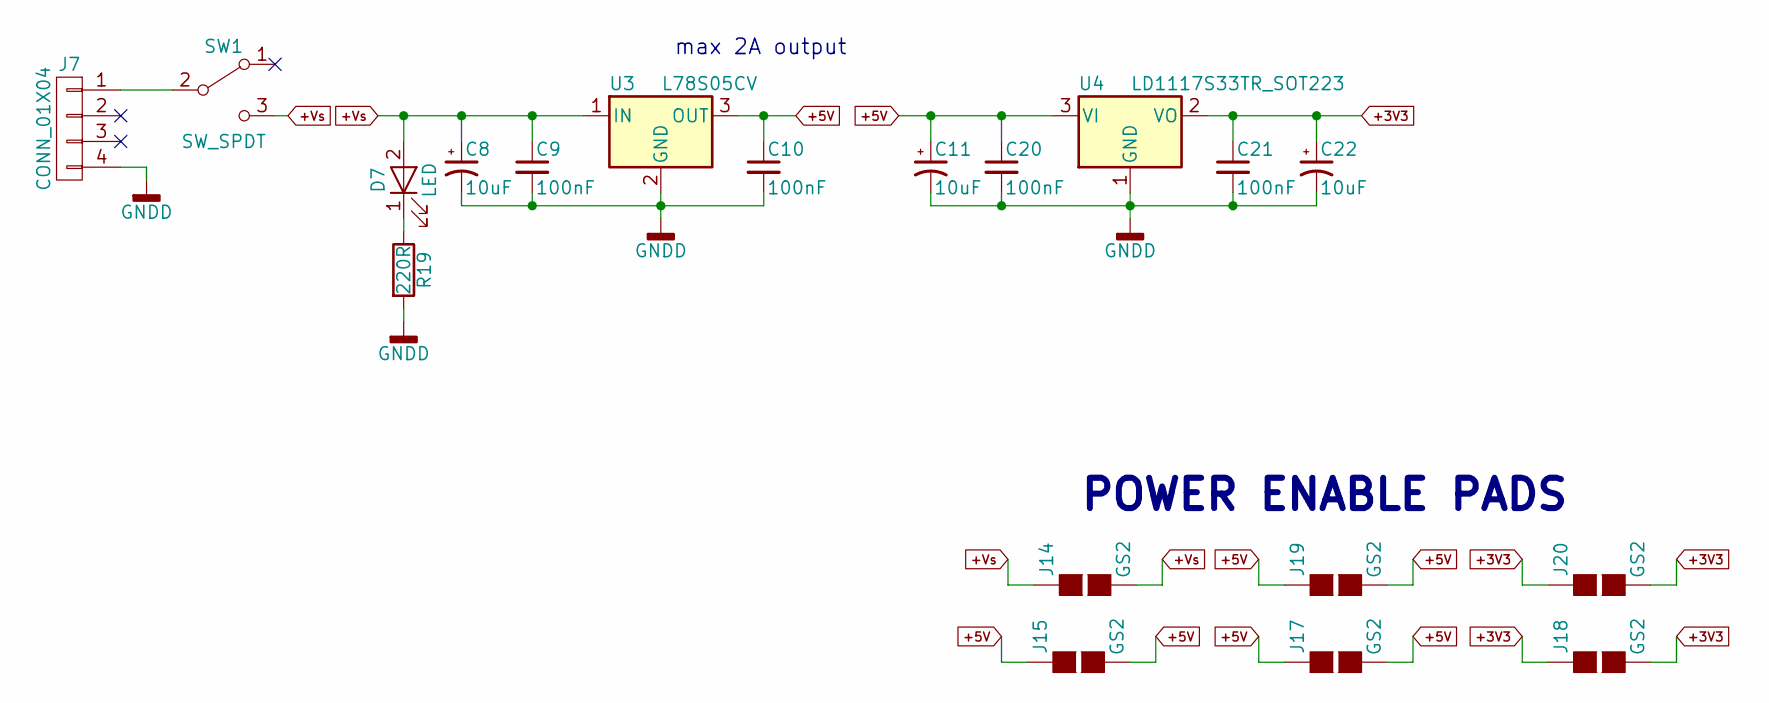
[picture p40: schematic power.sch]

Parts:
C8: 10uF; CP_Radial_D5.0mm_P2.00mm; part# UofG
C9: 100nF; C_Rect_L7.2mm_W3.0mm_P5.00mm_FKS2_FKP2_MKS2_MKP2; part# UofG
C10, C20, C21: 100nF; C_Rect_L7.2mm_W3.0mm_P5.00mm_FKS2_FKP2_MKS2_MKP2
C11, C22: 10uF; CP_Radial_D5.0mm_P2.00mm
D7: LED; LED_D3.0mm; part# UofG
J7: CONN_01X04; Molex_KK-41791-04_04x3.96mm_Straight
J14, J15, J17, J18, J19, J20: GS2
R19: 220R; R_Axial_DIN0207_L6.3mm_D2.5mm_P10.16mm_Horizontal; part# UofG
SW1: SW_SPDT; SPDT; part# UofG
U3: L78S05CV; TO-220-3_Horizontal; part# UofG
U4: LD1117S33TR_SOT223; TO-220-3_Vertical; part# UofG

Connections:
+3V3: C21.1, C22.1, J18.1 (G1), J18.2 (G2), J20.1 (G1), J20.2 (G2), U4.2 (VO); also elsewhere on the board
+5V: C10.1, C11.1, C20.1, J15.1 (G1), J15.2 (G2), J17.1 (G1), J17.2 (G2), J19.1 (G1), J19.2 (G2), U3.3 (OUT), U4.3 (VI); also elsewhere on the board
+Vs: C8.1, C9.1, D7.2 (A), J14.1 (G1), J14.2 (G2), SW1.3 (C), U3.1 (IN)
GNDD: C8.2, C9.2, C10.2, C11.2, C20.2, C21.2, C22.2, J7.4, R19.2, U3.2 (GND), U4.1 (GND); also elsewhere on the board
unnamed: D7.1 (K), R19.1
unnamed: J7.1, SW1.2 (B)

Notes on the sheet:
max 2A output
POWER ENABLE PADS

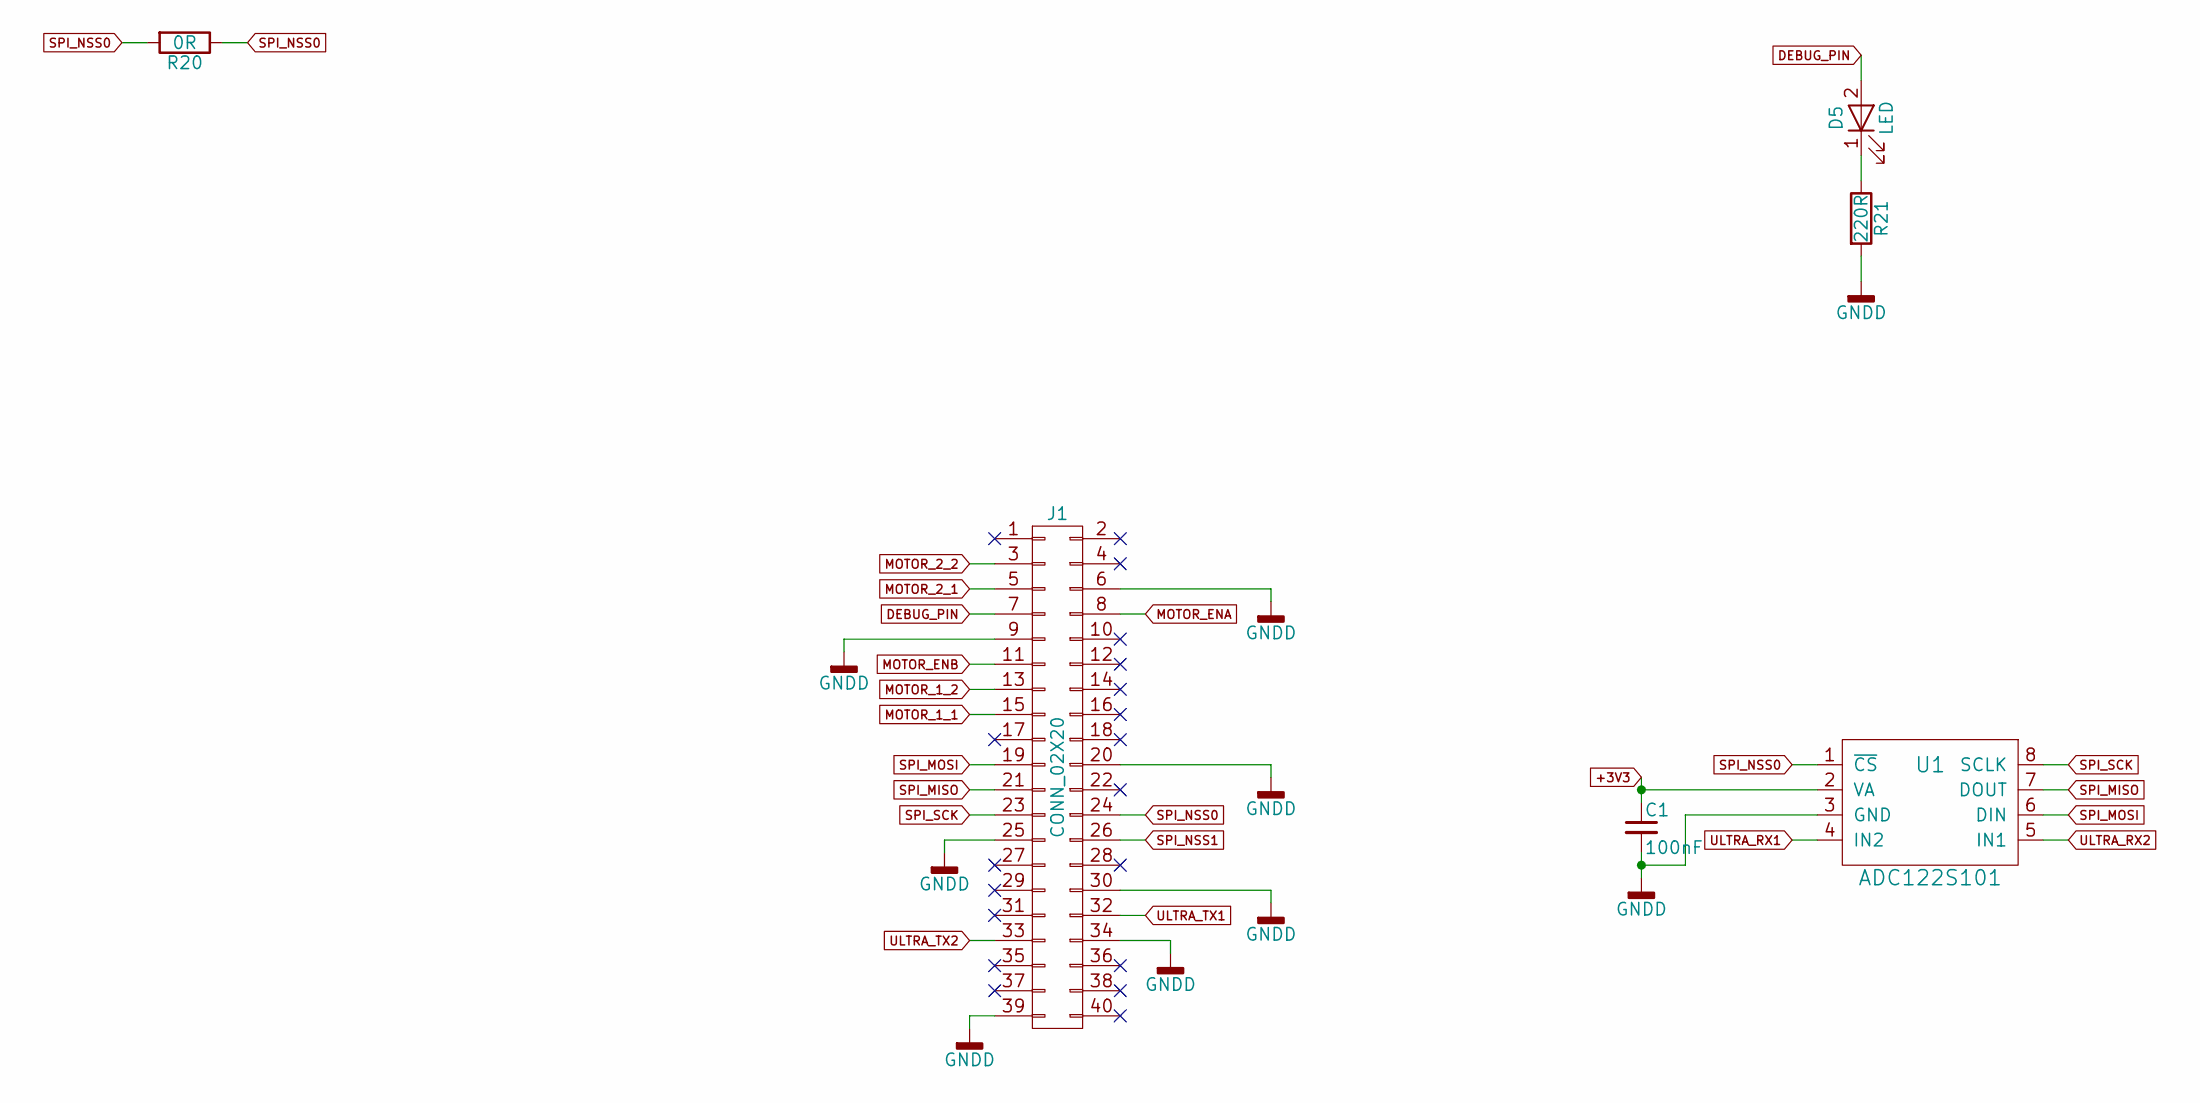
[picture p41: schematic rPi.sch]

Parts:
C1: 100nF; C_Rect_L7.2mm_W3.0mm_P5.00mm_FKS2_FKP2_MKS2_MKP2; part# UofG
D5: LED; LED_D3.0mm; part# UofG
J1: CONN_02X20; Pin_Header_Straight_2x20_Pitch2.54mm; part# UofG
R20: 0R; R_Axial_DIN0207_L6.3mm_D2.5mm_P10.16mm_Horizontal; part# UofG
R21: 220R; R_Axial_DIN0207_L6.3mm_D2.5mm_P10.16mm_Horizontal; part# UofG
U1: ADC122S101; MyVSSOP-8_3.0x3.0mm_Pitch0.65mm; part# ADC122S101CIMM/NOPB

Connections:
+3V3: C1.1, U1.2 (VA); also elsewhere on the board
DEBUG_PIN: D5.2 (A), J1.7
GNDD: C1.2, J1.6, J1.9, J1.20, J1.25, J1.30, J1.34, J1.39, R21.2, U1.3 (GND); also elsewhere on the board
MOTOR_1_1: J1.15; also elsewhere on the board
MOTOR_1_2: J1.13; also elsewhere on the board
MOTOR_2_1: J1.5; also elsewhere on the board
MOTOR_2_2: J1.3; also elsewhere on the board
MOTOR_ENA: J1.8; also elsewhere on the board
MOTOR_ENB: J1.11; also elsewhere on the board
unnamed: D5.1 (K), R21.1
SPI_MISO: J1.21, U1.7 (DOUT)
SPI_MOSI: J1.19, U1.6 (DIN)
SPI_NSS0: J1.24, R20.1, R20.2, U1.1 (~CS)
SPI_NSS1: J1.26
SPI_SCK: J1.23, U1.8 (SCLK)
ULTRA_RX1: U1.4 (IN2); also elsewhere on the board
ULTRA_RX2: U1.5 (IN1); also elsewhere on the board
ULTRA_TX1: J1.32; also elsewhere on the board
ULTRA_TX2: J1.33; also elsewhere on the board

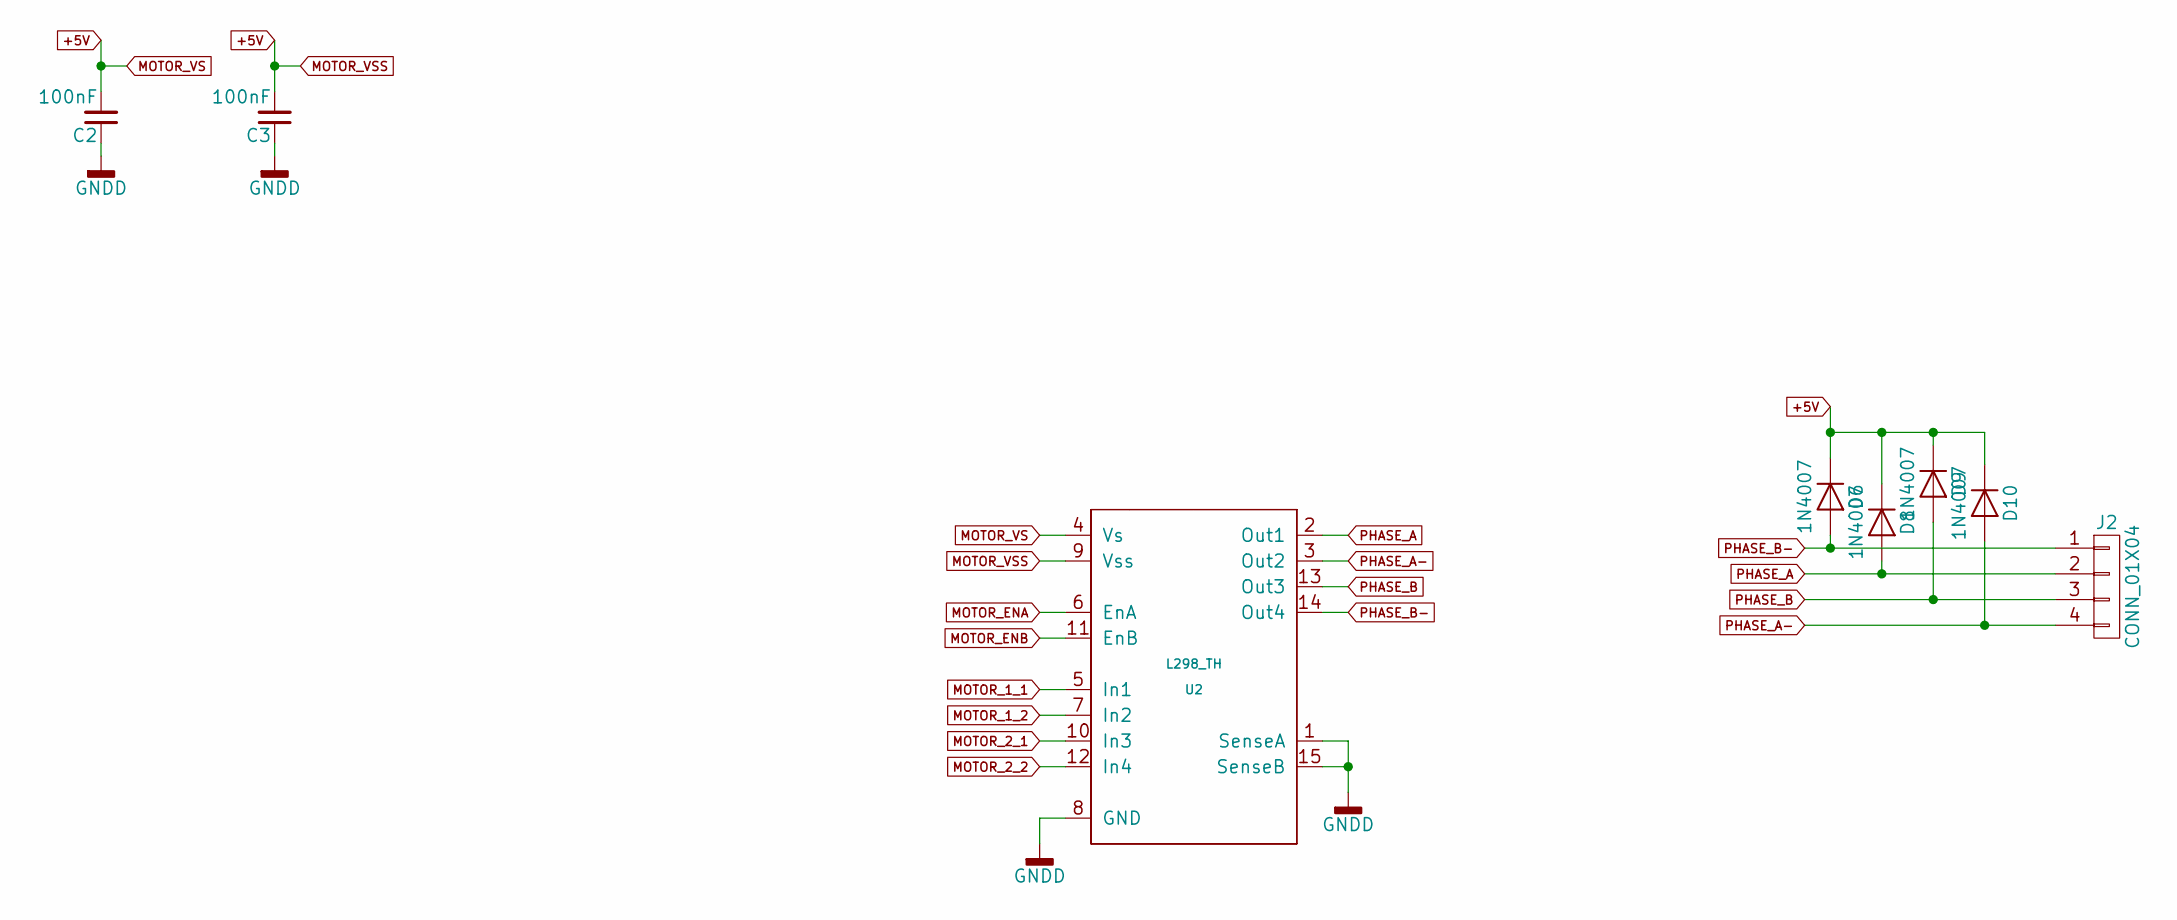
[picture p42: schematic motorDriver.sch]

Parts:
C2, C3: 100nF; C_Rect_L7.2mm_W3.0mm_P5.00mm_FKS2_FKP2_MKS2_MKP2; part# UofG
D6, D8, D9, D10: 1N4007; D_T-1_P10.16mm_Horizontal
J2: CONN_01X04; TerminalBlock_Altech_AK300-4_P5.00mm; part# UofG
U2: L298_TH; TO-220-15_Vertical_StaggeredType1; part# UofG

Connections:
+5V: C2.2, C3.2, D6.1 (K), D8.1 (K), D9.1 (K), D10.1 (K), U2.4 (Vs), U2.9 (Vss); also elsewhere on the board
GNDD: C2.1, C3.1, U2.1 (SenseA), U2.8 (GND), U2.15 (SenseB); also elsewhere on the board
MOTOR_1_1: U2.5 (In1); also elsewhere on the board
MOTOR_1_2: U2.7 (In2); also elsewhere on the board
MOTOR_2_1: U2.10 (In3); also elsewhere on the board
MOTOR_2_2: U2.12 (In4); also elsewhere on the board
MOTOR_ENA: U2.6 (EnA); also elsewhere on the board
MOTOR_ENB: U2.11 (EnB); also elsewhere on the board
PHASE_A: D8.2 (A), J2.2, U2.2 (Out1)
PHASE_A-: D10.2 (A), J2.4, U2.3 (Out2)
PHASE_B: D9.2 (A), J2.3, U2.13 (Out3)
PHASE_B-: D6.2 (A), J2.1, U2.14 (Out4)

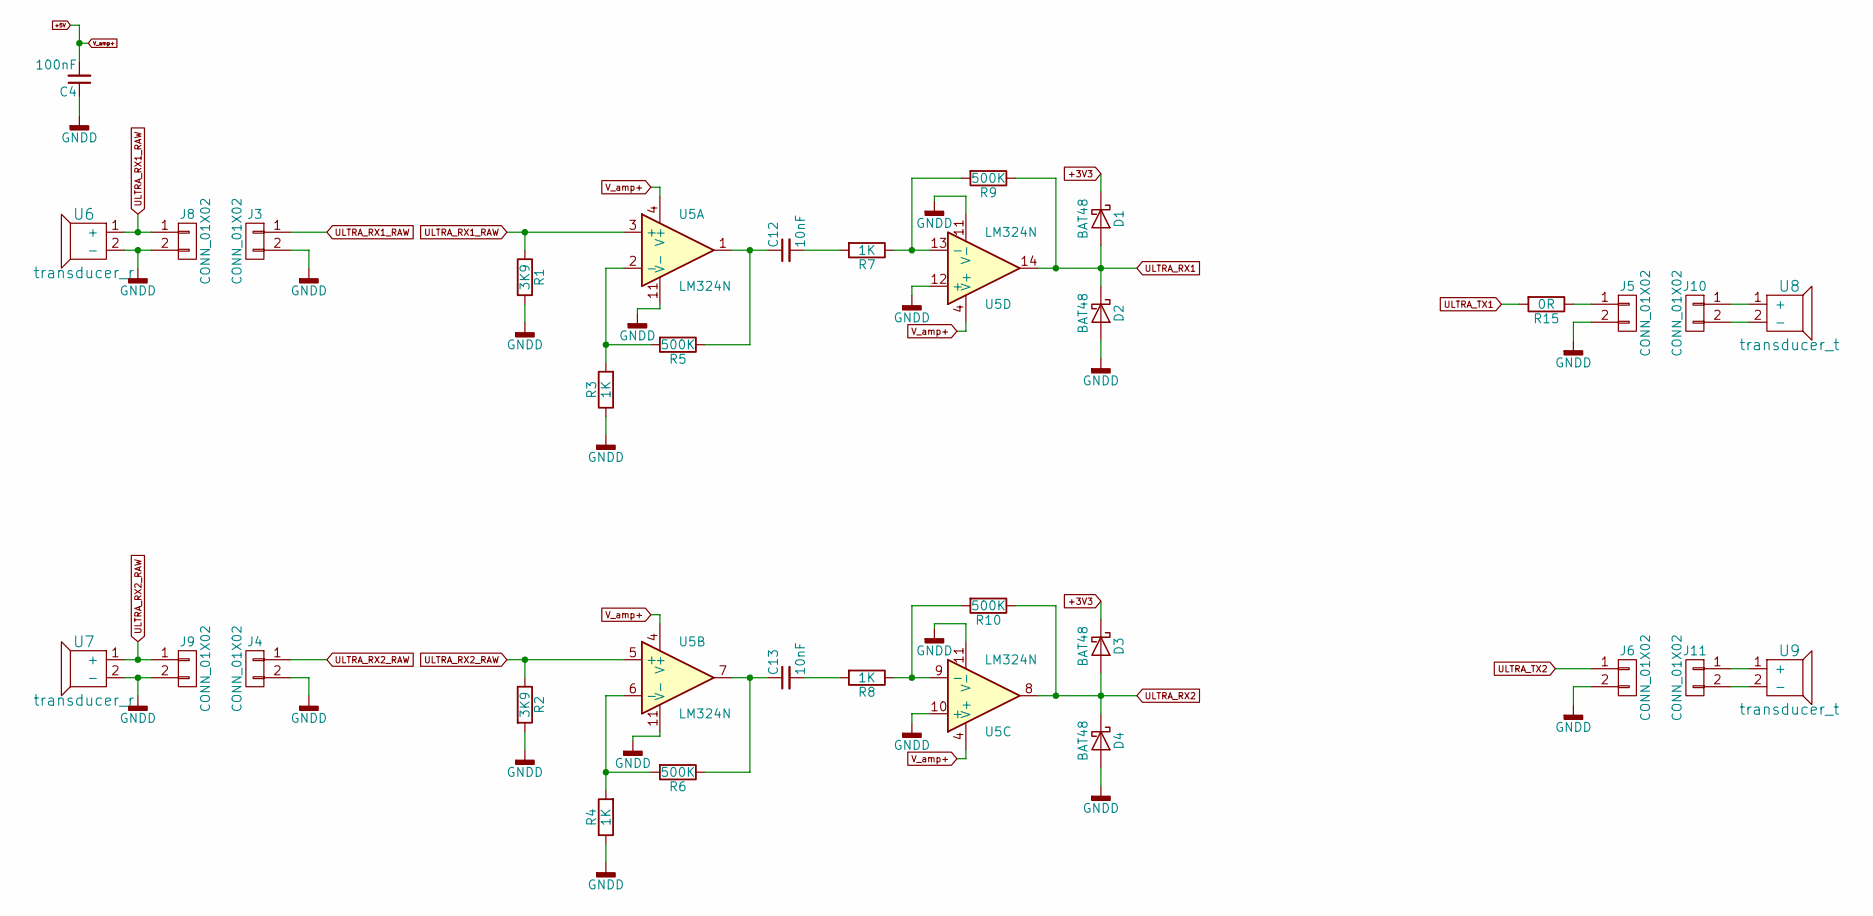
[picture p43: schematic ultrasound.sch]

Parts:
C4: 100nF; C_Rect_L7.2mm_W3.0mm_P5.00mm_FKS2_FKP2_MKS2_MKP2; part# UofG
C12, C13: 10nF; C_Rect_L7.2mm_W3.0mm_P5.00mm_FKS2_FKP2_MKS2_MKP2; part# UofG
D1, D2, D3, D4: BAT48; D_T-1_P10.16mm_Horizontal
J3, J4, J5, J6, J8, J9, J10, J11: CONN_01X02; TerminalBlock_Altech_AK300-2_P5.00mm; part# UofG
R1, R2: 3K9; R_Axial_DIN0207_L6.3mm_D2.5mm_P10.16mm_Horizontal; part# UofG
R3, R4, R7, R8: 1K; R_Axial_DIN0207_L6.3mm_D2.5mm_P10.16mm_Horizontal; part# UofG
R5, R6, R9, R10: 500K; R_Axial_DIN0207_L6.3mm_D2.5mm_P10.16mm_Horizontal; part# UofG
R15: 0R; R_Axial_DIN0207_L6.3mm_D2.5mm_P10.16mm_Horizontal
U5: LM324N; DIP-14_W7.62mm_LongPads; part# UofG
U6, U7: transducer_r; transducer; part# MA40S4R
U8, U9: transducer_t; transducer; part# MA40S4S

Connections:
+3V3: D1.1 (K), D3.1 (K); also elsewhere on the board
+5V: C4.2, U5.4 (V+); also elsewhere on the board
GNDD: C4.1, D2.2 (A), D4.2 (A), J3.2, J4.2, J5.2, J6.2, J8.2, J9.2, R1.2, R2.2, R3.1, R4.1, U5.10 (+), U5.11 (V-), U5.12 (+), U6.2 (-), U7.2 (-); also elsewhere on the board
unnamed: C12.1, R5.1, U5.1
unnamed: C12.2, R7.2
unnamed: C13.1, R6.1, U5.7
unnamed: C13.2, R8.2
unnamed: J5.1, R15.1
unnamed: J10.1, U8.1 (+)
unnamed: J10.2, U8.2 (-)
unnamed: J11.1, U9.1 (+)
unnamed: J11.2, U9.2 (-)
unnamed: R3.2, R5.2, U5.2 (-)
unnamed: R4.2, R6.2, U5.6 (-)
unnamed: R7.1, R9.2, U5.13 (-)
unnamed: R8.1, R10.2, U5.9 (-)
ULTRA_RX1: D1.2 (A), D2.1 (K), R9.1, U5.14; also elsewhere on the board
ULTRA_RX1_RAW: J3.1, J8.1, R1.1, U5.3 (+), U6.1 (+)
ULTRA_RX2: D3.2 (A), D4.1 (K), R10.1, U5.8; also elsewhere on the board
ULTRA_RX2_RAW: J4.1, J9.1, R2.1, U5.5 (+), U7.1 (+)
ULTRA_TX1: R15.2; also elsewhere on the board
ULTRA_TX2: J6.1; also elsewhere on the board

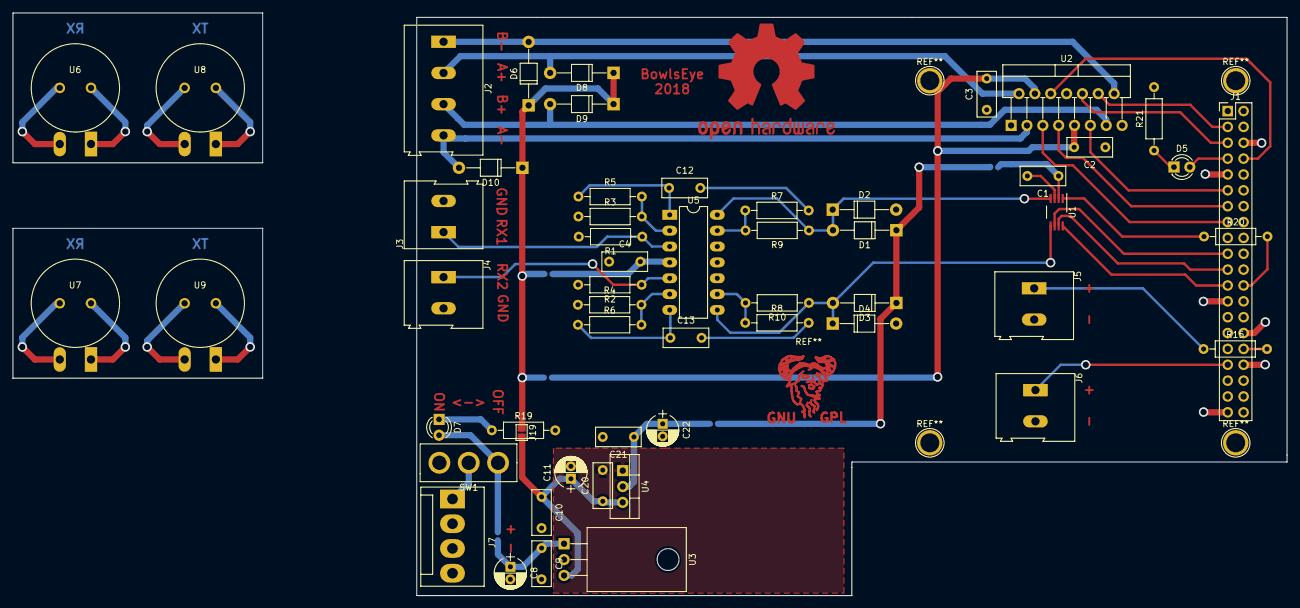
[picture p44: board Proto2.kicad_pcb from above]

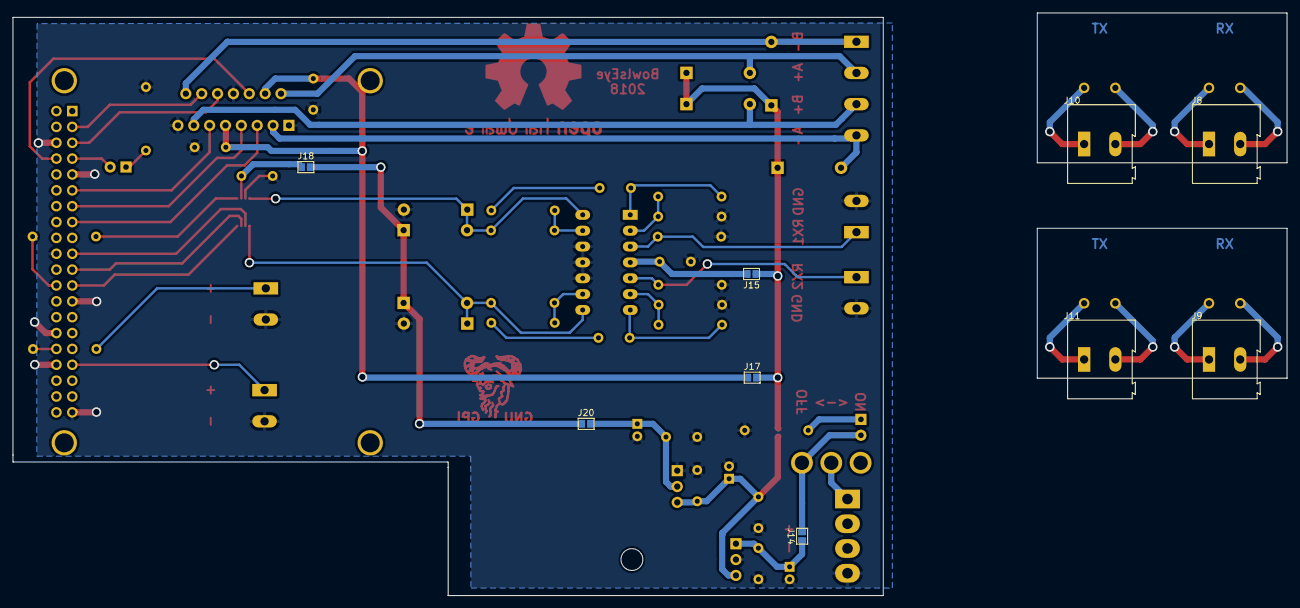
[picture p45: board Proto2.kicad_pcb from below]

Board: 2 copper layers, 139.4 x 92.6 mm, 64 parts (9 on the bottom side), 41 nets.
