rv456/BowlsEye/Code/StepperMotor/stepper.c

#include <string.h>
#include "stepperMotor.h"

int RUN = 1;

void exitHandler(int s){
	
	RUN = 0;
}


int main(int argc, char** argv)
{

	struct sigaction sigIntHandler;

	sigIntHandler.sa_handler = exitHandler;
	sigemptyset(&sigIntHandler.sa_mask);
	sigIntHandler.sa_flags = 0;

	sigaction(SIGINT, &sigIntHandler, NULL);

    pi = pigpio_start(NULL, NULL);

    if (pi < 0) return -1;

   
    StepperMotor_construct(&stepper, 100);

    gpio_write(pi, 4, 1);
    
   
    while(RUN){
	
		for(uint8_t i=0; i<4; i++){

			StepperMotor_update(&stepper);
			time_sleep(0.2);
		}
	
		StepperMotor_setDirection(&stepper, DIRECTION_ANTICLOCKWISE_);
		
		StepperMotor_setStepSize(&stepper, 200);
		
		for(uint8_t i=0; i<4; i++){
			
			StepperMotor_update(&stepper);
			time_sleep(0.2);
		}
		
		StepperMotor_setDirection(&stepper, DIRECTION_CLOCKWISE_);
		StepperMotor_setStepSize(&stepper, 100);
    }

    printf("\ntidying up\n");

	StepperMotor_disable(&stepper);

	gpio_write(pi, 4, 0);

    pigpio_stop(pi);

    return 0;
}
