rv456/BowlsEye/Code/Pi_BowlsEyeMain/transducer.h

/*!
 * @file transducer.h
 */

#include <pigpio.h>

#define NO_PULSES_			16

#define TX_0_PIN_			12
#define TX_1_PIN_			13


/*!
 * @brief Structure for exciting the transducers
 */
typedef struct{

	gpioPulse_t pulseInfo[NO_PULSES_];		/*!<Pulse information*/
	int pin;								/*!<Excitation pin*/
	uint32_t wid;							/*!<Wave identifier*/
}Transducer_t;

Transducer_t tx0;
Transducer_t tx1;

Transducer_t *transducer[2];

void Transducer_construct(Transducer_t *transducer, int pin, int onTime, int offTime);
void Transducer_excite(Transducer_t *transducer);
void Transducer_disable(Transducer_t *transducer);
void Transducer_config(void);
