rv456/BowlsEye/(commit log)

2018-01-24 Added Motor data sheet
2018-01-31 Added ADC breakout board
    [ADCBreakout.kicad_pcb, ADCBreakout.sch, _saved_ADCBreakout.sch]
2018-02-07 Added pdf of ADCBreakout board
2018-02-08 Added thread test Does hello world blinking on new thread
2018-02-08 Added pinout/mapping for Rpi GPIO connector
    [ADCBreakout.sch, _saved_ADCBreakout.sch]
2018-02-08 Added some stepper motor resources
2018-02-12 Started SPI testing
2018-02-12 More spi testing
2018-03-13 Added WIP proto1 schematic
    [Proto1.kicad_pcb, Proto1.sch, motorDriver.sch, power.sch, rPi.sch, ultrasound.sch]
2018-03-13 Added PWM demo
2018-03-13 Added stepper motor code
2018-03-14 improved stepper motor code
2018-03-14 updated schematic
    [motorDriver.sch, rPi.sch]
2018-03-15 removed hello world
    [Proto1.kicad_pcb, motorDriver.sch, power.sch, rPi.sch, ultrasound.sch]
2018-03-15 added PCB and PDF of schematics
    [Proto1.sch, motorDriver.sch, power.sch, rPi.sch, ultrasound.sch]
2018-03-19 updated PCB and added fab files/bom
    [BOMfull.csv, Proto1.kicad_pcb, Raspberry-Pi-B-Plus-V1.2-Mechanical.dxf, motorDriver.csv, power.csv, rPi.csv, rPi.sch, ultrasound.csv]
2018-03-20 changed socket port for gui
    [Proto1.kicad_pcb]
2018-04-02 added bluetooth control over stepper motor
2018-04-06 added adc test code
2018-04-08 Auto stash before merge of "master" and "origin/master"
    [Proto1.kicad_pcb, Proto1.sch, Proto2.kicad_pcb, Proto2.sch, _saved_Proto2.sch, motorDriver.sch, power.sch, rPi.sch]
2018-04-08 Added proto2 kicad files
    [Proto1.sch, Proto2.kicad_pcb, _saved_Proto2.sch, motorDriver.sch, power.sch, rPi.sch, ultrasound.sch]
2018-04-08 Added pdfs of proto2
    [BOMfull.csv, Proto2.kicad_pcb, motorDriver.csv, motorDriver.sch, power.csv, power.sch, rPi.csv, rPi.sch]
2018-04-09 Finished proto2 board
    [Proto2.kicad_pcb, Proto2.sch, motorDriver.sch, power.sch, rPi.sch, ultrasound.sch]
2018-04-11 Added test file for pwm and spi
2018-04-11 added scope traces of ultrasound experiments
2018-04-15 added clearing graphic to gui
    [_saved_motorDriver.sch]
2018-04-15 added pngs of pcbs
    [Proto1.kicad_pcb, Proto2.kicad_pcb, _saved_motorDriver.sch, motorDriver.sch]
2018-04-16 added cad files
    [box_model_v1.f3d]
